gzweigle/DIY-Grand-Digital-Piano/(threads)

Thread 3 (2023-11-26):

add hardware project files

gzweigle, 2023-11-26:
Released are gerber only.

gzweigle, 2024-04-07:
Done. Added KiCad project files and the KiCad libraries I created.

Closed 2024-04-07.

Thread 6 (2023-12-10):

HW: USB MIDI?

davidedelvento, 2023-12-10:
Great to see that you included DIN-MIDI. It's not clear if the now-more-popular USB-MIDI is supported already. If not, it should be relatively easy to add, since the Teensy 4.1 can act as a USB Host. I did that with the [pico](https://github.com/davidedelvento/Mybrid/tree/main/RaspberryPiPico) using https://github.com/hathach/tinyusb so it should be similarly easy on the Teensy (if not done already -- if done already, this "bug" is mentioning it on the main README)

gzweigle, 2023-12-10:
I wish Teensy was not host.  But yeah good suggestion for future.

gzweigle, 2024-09-02:
I added to the IPS 2.1 enhancement list.
Closing this issue since it is now a duplicate

Closed 2024-09-02.

Thread 7 (2023-12-10):

FW: Pedal options?

davidedelvento, 2023-12-10:
The README mentions the option to use external pedals with 1/4" connections, which is great.

Some people (like me :wink: ) may would like to use an existing acoustic pedal, with a sensor similar/identical to the ones for the keys/dampers.

Looking at https://github.com/gzweigle/DIY-Grand-Digital-Piano/tree/main/packages/StemPianoG#pedal-connections it may seem that this is already possible, if my understanding is correct. If so, update the main README accordingly, specifying this option, otherwise let's discuss here what it would take to make it possible

gzweigle, 2023-12-10:
StemPianoG code does not support (yet) but hardware does support. So, I will leave here as an enhancement idea, then update documentation if code is modified in future.

gzweigle, 2024-09-02:
code supports, if needs modification for a specific pedal model will open a new issue for that case.

Closed 2024-09-02.

Thread 8 (2023-12-10):

Number of SCA cards

davidedelvento, 2023-12-10:
If my understanding is correct, one needs 16 SCA cards for the hammers and 16 for the dampers. Is that correct?
If so, write it in the paragraph https://github.com/gzweigle/DIY-Grand-Digital-Piano/tree/main/packages/StemPianoG#six-channel-analog-pcb-link

gzweigle, 2023-12-10:
Just one is needed. I clarified in documentation per suggestion. Thanks!

Closed 2023-12-10.

Thread 9 (2023-12-10):

FW, ME: Selecting hammers/dampers in the IPS boards

davidedelvento, 2023-12-10:
Let's assume that one wants to have both hammers and dampers sensors. If my understanding is correct, current firmware require wiring *all* hammers (via SCA boards) to one IPS board and *all* dampers (again via SCA boards) to *the other* IPS board.

I think it would make it much easier wiring (shorter wires and less crossing cables) and much more efficient use of resources if each board could be configured (in firmware) to act as a hybrid hammers/dampers IPS for half the keyboard. The wiring is clear: you will be wiring only half the keyboard to one board, and the other half to the other board, halving the total length of the cables (potentially reducing noise when doing so, but I am not sure).

For the "more efficient use of resources" consider this scenario to begin: nothing is playing on the piano, both boards (and their ADCs in the SCA boards) are "frantically" sampling all sensors waiting for something to happen. Well, sampling the dampers is unnecessary, so that's the first waste, but that's not my main concern. The main concern is that sampling must be fast to make sure the latency between "key is played" and "MIDI signal is sent" is the lowest possible. Since the ADCs are multiplexed, we are not as fast as possible with the hardware we have. If a single board could be used to sample *both* hammers and dampers, the ADCs can be multiplexed at twice the frequency (because there is no need to check the damper until the note has been played), effectively having the ADC latency with no change in hw. Similarly, the software could probably be prevented from spending cycles checking the dampers until the note is played.

Of course this optimization cannot be used when a note is being held, because in such scenario it could be either re-played or it could be released and to detect what happens we must sample both the hammer and the damper sensor. But only about 10 notes can be held at a same time (given the players typically have 10 fingers), so *still* the optimization will work with 78/88 ~ 88% efficiency! It would be particularly useful if the dampers for one note will be assigned to a SCA board *different* from the corresponding hammer. Why? Because as described above when a note is held one has to monitor both hammer and damper and that would decrease the sampling rate when one needs it most, i.e. when the likelihood of repetitions and nearby note playing is highest.

Would this be extremely complicated with current firmware (which I have not studied yet) or is it doable? I'm willing to contribute to software and wiring scheme design if you deem it worthwhile.

gzweigle, 2023-12-10:
The present released code scans all 96 inputs every 400 microseconds (adc_sample_period_microseconds in hammer_settings.cpp).
My plan to go faster was more ADC on SCA, running in parallel (up to 6x fast is possible).
But agree, another approach is as described above.  No board spins needed.

gzweigle, 2024-06-10:
An advantage of present approach is single MIDI output.
Also, I have optimized the firmware to get the sample period down to 300 microseconds.

I've been playing the piano regularly for over half a year and the piano plays very well at this sample rate. Especially after fixing many sources of error (per YouTube video I recently posted).

My roadmap for faster sample rate remains the ADC parallelization on SCA, which requires only changes to the small, removable, SCA card.

The proposed architecture is very interesting but I in the interest of keeping the backlog small, I am considering to close this issue. Comments?

davidedelvento, 2024-06-10:
Yes, single MIDI out is highly desirable, but I don't see how it's relevant here? Probably just my ignorance here, this is what I am thinking: if you have separate hammer and damper boards each with 88 (or 96) channels, vs having two boards each one using half the keys but both hammers and dampers? If you need single MIDI out, in both cases the two boards need to communicate with each other and consolidate the output. If that consolidation code does not exist yet and it's not a priority to write it yet, in one case you have note-on from one board and note-off from another (which can be problematic for digital instruments), whereas in the other you have note-on and note-off from the same board (just for different note-number) which should be easier on the receiving size.

Moreover, IMHO, one big advantage of this approach is also the wiring: each board can be located closer to the relevant keys, simplifying wiring a lot.

Regarding your actual question about the ADC thing, I have no strong opinion, and the only opinion I have is not backed by data, since I have not been using a complete instrument as you have. I would just note that this aspect may be related to #55 but on that topic too you know that part better than I can comment.

So in conclusion, my opinion is that this is still a desirable feature to implement (leave the issue open), even though it may not be as important for some of the goals I originally mentioned, such as increase ADC rate (deprioritize).

gzweigle, 2024-06-10:
I am happy to leave open. I agree on the wire length benefit.

With present architecture, dampers are optional.  Just add a damper board (identical to hammer board). Nothing else changes.

With respect to MIDI - it is output from the hammer board only.  Damper measurements are sent over CAN bus from damper board to hammer board. Hammer board consolidates to a single MIDI output.  The dampers, as you correctly noted, require less resolution and so I was able to fit all damper data over the relatively slow CAN bus.

gzweigle, 2024-06-10:
Here is the damper board to hammer board code:

https://github.com/gzweigle/DIY-Grand-Digital-Piano/blob/main/firmware/releases/StemPianoIPS2/src/board2board.cpp

gzweigle, 2025-04-26:
Its been a while. All info remains in the issue history and can find with * search.

Closed 2025-04-26.

Thread 12 (2024-01-01):

Vref and sensor resistor

gzweigle, 2024-01-01:
I can get better accuracy by changing the SCA voltage reference part and the HPS load resistor value.

gzweigle, 2024-01-04:
bill of materials have been modified to change load resistor and reference.
Need to test with hardware before closing the issue.

Closed 2024-01-15.

Thread 13 (2024-01-13):

FW: repetition false strike

gzweigle, 2024-01-13:
repro:
Press piano key quickly.
Slowly release key until jack moves beneath knuckle.
Hammer moves up.
On an acoustic piano, hammer does not hit string.
With stem piano sometimes get a false strike.

soln:
Probably can fix with firmware and might also need more consistent sensor placement.

davidedelvento, 2024-01-14:
> With stem piano sometimes get a false strike.

I haven't looked at your code, but with other codes I've played with (mine and Jay's), this is the first basic calibration that one needs to do! That's the advantage to have a mostly software (unlike Cybrid which is mostly hardware) design.

You have to play slowly (actually could even just raise the hammer manually rather than with the key) without hitting the string/sensor. That needs to be calibrated as "let off" position. Then you have to have the hammer hitting the string/sensor and calibrate that as "play" or something. You need to do that for each and every key because both the sensors and their placement will be different from one key to another. On Cybrid, you do that with the potentiometers (huge pain), with Mybrid and Jay's piano-conversion (and I assume you can do that with yours) you write a routine in which you ask the player to play each and every key first silently then not-silently and use those 88+88 values from the ADCs as calibration values. A fancy calibration GUI/script may allow to recalibrate only some notes rather than everything or globally shift everything up or down etc.

davidedelvento, 2024-01-14:
See also: https://github.com/jkominek/piano-conversion/wiki/Calibration-Procedure

gzweigle, 2024-04-20:
this seems to have been fixed by other changes. will close for now and reopen if happens again.

Closed 2024-04-20.

Thread 14 (2024-01-13):

ME: note consistency

gzweigle, 2024-01-13:
repro:
Play multiple notes with same velocity. For example, using a ruler.
MIDI value is not exactly same for all notes.

soln:
Probably sensor consistency.
ADC - differential?

davidedelvento, 2024-01-14:
Again, https://github.com/jkominek/piano-conversion/wiki/Calibration-Procedure has some ideas on this. One could make the calibration procedure I described in #13 also ask for a fff strike and use that to calibrate the slope of the velocity computation. That is a bit tricky because while it's easy to raise the hammer to let-off without it going much higher, and it's also easy to have the hammer strike the sensor/string with "whatever" velocity, it's much harder to make it strike it with consistent velocity. I speculate (and my preliminary tests I described in the Mybrid repo confirm) that this calibration is not necessary once one has calibrated the let-off and the strike point and hence measured velocity only between these two values. But then I only had a handful of notes working, never a full set as you do, so I might be missing something, either on the user "feeling" side or on the sensor variability side. Also, my sensors different than yours and are probably mounted with a bit tighter tolerances, as you have probably already seen at https://pianoclack.com/forum/d/542-update-on-piano-conversion/

gzweigle, 2024-01-15:
I'm in the process of checking in details of a system I built to accurately measure sensor response.

gzweigle, 2024-04-20:
improved by a combination of rebuild/regulate action, redrill sensor bar with more accuracy, and real-time algorithm in firmware (code is in repo now)

Closed 2024-04-20.

Thread 15 (2024-01-13):

power supply noise

gzweigle, 2024-01-13:
repro:
Detailed measurements show quite a bit of 120 Hz noise.

soln:
Better +5V power supply.
Look at grounding.
Differential ADC.
Filters.

davidedelvento, 2024-01-14:
One of the most notably effect of power supply noise is on the intensity of the LED light, which in turns would cause a change of measured distance (unless it's very carefully calibrated, which IMHO is a big pain) with that frequency. That could turn out as a subtle modulation of the velocity at that frequency, since when we are in a peak intensity the hammers would appear to be closer (and hence hit the string/sensors earlier, and hence have a higher velocity/loudness) and the reverse when we are in a trough with hammers appearing more distance and etc-etc lower velocity/loudness.

See https://github.com/jkominek/piano-conversion/wiki/LED-Power-Board for a solution to this problem, which also has the added benefit to removing the needs of all those current-limiting resistors which are needless power sink. Not much each, but even a fraction of a watt when multiplied by 176 becomes non-negligible (that explain the lack of such resistors in my sensorboards as we were discussing elsewhere)

gzweigle, 2024-01-21:
Turns out this was due to ambient room lighting shining on the sensors.
With sensors shielded, the 120 Hz noise goes away.

Closed 2024-01-21.

Thread 16 (2024-01-13):

FW: CNY70 accuracy

gzweigle, 2024-01-13:
Working on calibration for nonlinearity and sensor-to-sensor variations.
Need to improve sensor placement variation.

gzweigle, 2024-04-20:
combination of rebuild/regulate action, redrill sensor bar with more accuracy, and real-time algorithm in firmware (code is in repo now)

Closed 2024-04-20.

Thread 17 (2024-01-13):

ME: wiring

gzweigle, 2024-01-13:
Working on cleaner wiring of boards and sensors.

davidedelvento, 2024-01-14:
You have seen this https://pianoclack.com/forum/d/637-build-your-own-hybrid-piano-step-four-the-cables haven't you?

gzweigle, 2024-08-10:
Will do someday but since not documented in GitHub, no need for an open issue.

Closed 2024-08-10.

Thread 18 (2024-01-13):

normalization and gain control

gzweigle, 2024-01-13:
This code is presently a work-around.
gain_control.cpp
vscale in src_hammer.cpp
Needs rethinking.
For example, eliminate velocity normalization with the switches.  Make it auto.

gzweigle, 2024-03-31:
I removed most of this code.

Closed 2024-03-31.

Thread 19 (2024-01-21):

FW: wrong hammer distance

gzweigle, 2024-01-21:
In hammer settings, this distance is measured at the CNY70 sensor location (.3125 inches).  It should be the distance at the hammer (closer to about 2 inches).
hammer_travel_meters = .0254 * 0.3125;

gzweigle, 2024-04-20:
subset of issue #28

Closed 2024-04-20.

Thread 20 (2024-01-23):

the video "Step 4 - Piano Action Frame" is private. Could you give a new link?

BetsyTsng, 2024-01-23:
the video "Step 4 - Piano Action Frame" is private. Could you give a new link?

BetsyTsng, 2024-01-24:
i really need this video to learn how to make frame of the action.

davidedelvento, 2024-01-27:
https://pianoclack.com/forum/d/170-build-your-own-hybrid-piano-step-two-the-cabinet/7

BetsyTsng, 2024-01-28:
sorry, i read carefully this repo, and found that this video just not be done.

gzweigle, 2024-01-29:
Thanks, yes it is not done.

gzweigle, 2024-03-17:
I changed the video to public and also made a video documenting issues with it.

Closed 2024-01-29.

Thread 21 (2024-02-20):

Video for "Piano Action Frame" is set to private

WebSnke, 2024-02-20:
Hi, I am a huge fan of this project and would love to build my own. However, the video for building the piano action frame is set to private.
Is this intentional or just a mistake?

davidedelvento, 2024-02-20:
Duplicate of #20

gzweigle, 2024-02-22:
https://github.com/gzweigle/DIY-Grand-Digital-Piano/discussions/22

WebSnke, 2024-02-23:
> Duplicate of #20

Yeah, noticed that too...
Btw, has anyone managed to put this into an upgright piano action?

davidedelvento, 2024-02-24:
> has anyone managed to put this into an upgright piano action?

That would be better for another issue or a discussion item e.g. on https://pianoclack.com/forum/

Hope Greg don't mind too much for me answering here instead. I don't think anybody has done that. In a nutshell, upright pianos have the following limitations:

* the action is harder to remove (not extremely hard, but harder than grand) and when removed, unless you have specialized equipment, you are guaranteed to break it because it you cannot lay it in any position without having the whole weight pushing on a brittle part, unlike in a grand where you can just pull it out and place it on any table
* the keyboard is part of the cabinet and cannot be removed, if not one key at the time (and then you need to rebuild a keyframe), unlike in a grand where the keyboard is attached to the action
* if you want to reuse the upright cabinet you may want to remove the harp to make it lighter. This is close to impossible (unlike in a grand, where it is easy if you have a hoist, and demanding but not too hard if you work with *several* people in the operation)
* if you don't remove the harp, you have to remove all the strings, which is a very long, tedious and dangerous job -- at that point you have very limited working space for the sensors. Again, not impossible, but much harder than a grand
* assuming that you succeed in all of the above, you end up with an arguably inferior action than a grand, after having done much more work -- hence I don't see why one would embark in such an endeavor.
* anticipating an answer of "but I don't have room for a grand in my house", my comment is "me neither" and in fact I made an "upright" (actually a spinet) out of a grand action. That was EASY. See https://pianoclack.com/forum/d/170-build-your-own-hybrid-piano-step-two-the-cabinet for details.

WebSnke, 2024-02-24:
Thanks for your response. Let's continue this on the forum.

Closed 2024-02-20.

Thread 23 (2024-03-31):

TFT doesn't clear

gzweigle, 2024-03-31:
When switch to display mode, it doesn't clear properly.

gzweigle, 2024-04-13:
fixed

Closed 2024-04-13.

Thread 25 (2024-04-07):

HW: surface mount HPS without trimmer

gzweigle, 2024-04-07:
The surface mount HPS (v6 and v7) also include the trimming resistor.
The trimming resistor is expensive.
Need a surface mount version of HPS without the trimming resistor.
So, same as v4 but surface mount.

gzweigle, 2024-04-20:
HPS 0.8 is in testing.

gzweigle, 2024-05-05:
Added - https://github.com/gzweigle/DIY-Grand-Digital-Piano/tree/main/hardware/releases/hps08/hps08_gerber
Until fully tested, leaving issue open

gzweigle, 2024-06-09:
it works

Closed 2024-06-09.

Thread 26 (2024-04-14):

HW: pedal voltage exceeds Vref

gzweigle, 2024-04-14:
The pedal inputs have pullups to VDD.
Two problems:
1. clipping at ADC.
2. The ADC max input is Vref + 0.3V.

The firmware handles this ok. Its been working for months.

However, should add a resistor to IPS 2.0 PCB to keep voltage in range 0 to Vref.
Use design from first architecture:
https://youtu.be/9sqkgVXceJU?t=63

gzweigle, 2024-04-16:
Looks like I can fix this, without changing any existing PCB, by making a tiny removable resistor divider board that snaps on IPS.
Because fortunately I connected the pedals through a header.
In hindsight, this is the preferred approach anyway because VREF is configurable.
Missing the impact of configurable VREF on pedals is what caused the "hardware bug".
So, need a configurable pedal output voltage. Hence the new board.
In process of building and testing the idea.

gzweigle, 2024-06-09:
Added the hardware files and updated the documentation.

Closed 2024-06-09.

Thread 27 (2024-04-14):

HW: crosstalk

gzweigle, 2024-04-14:
In working on note-to-note consistency, I notice a slight cross-talk between channels (notes).
Need to track this down.

davidedelvento, 2024-04-14:
I suspect optical crosstalk from the sensors themselves. I noticed this in my preliminary testing and it is one of the reasons I settled on the QRE1113 rather than the CNY70

gzweigle, 2024-04-14:
Interesting.  I will investigate. Am thinking (hoping) that it is an issue with my test setup, not the circuits.

I am taking very precise test position measurements so seeing interesting phenomena. For example, measurements influenced by leaning against piano slightly during test!

gzweigle, 2024-04-14:
test setup

Closed 2024-04-14.

Thread 28 (2024-04-15):

FW: velocity to midi

gzweigle, 2024-04-15:
Algorithm is a proportional mapping.
Adjustments have been with external MIDI software velocity curve.
Needs:
1. Rigorous derivation of correct relationship.
2. Documentation.

gzweigle, 2024-05-04:
Keep proportional.
Add calibration option.

Closed 2024-05-04.

Thread 31 (2024-04-21):

FW: damper code out of date

gzweigle, 2024-04-21:
Been testing and editing firmware with hammers to estimate dampers.
Need to bring code for separate damper board up to date.

gzweigle, 2024-07-21:
fixed

Closed 2024-07-21.

Thread 33 (2024-04-27):

HW: higher current LDO

gzweigle, 2024-04-27:
1.75A / 6 = 291mA which is too close to the 300mA in parts list.

gzweigle, 2024-04-27:
Consider TLV755P (500mA) in place of existing TLV733P (300mA).  Also increase input / output capacitance.

The stem piano documentation says 1.75A. The test results were 1.5A.

1.5A / 6 = 250mA < 300mA LDO.

However, one of the LDO is also powering the SCA.

gzweigle, 2024-04-28:
More clearly explain HPS current constraints:
https://github.com/stem-piano/stem-piano-g-main/blob/main/documentation/component_manual.md

Add HPS current measurement table:
https://github.com/gzweigle/DIY-Grand-Digital-Piano/tree/main/hardware/releases/hps07

Closed 2024-04-28.

Thread 38 (2024-04-27):

DOC: min HPS output voltage

gzweigle, 2024-04-27:
I put 2.25V in the documentation. Lower should be possible.

https://github.com/stem-piano/stem-piano-g-main/blob/main/documentation/hps_testing.md

gzweigle, 2024-04-28:
Verify that lower works and adjusted the documentation.

Closed 2024-04-28.

Thread 40 (2024-04-28):

FW: small voltage calibration

gzweigle, 2024-04-28:
For HPS-70 that are far from nominal, may need a two-step calibration.
First a gain, then the curve adjust.

gzweigle, 2024-06-10:
Analysis and testing shows the existing automatic calibration algorithm works well even for outliers.
Therefore, not going to work on a two-step calibration algorithm.

Closed 2024-06-10.

Thread 41 (2024-05-04):

HW: no sca connector labels on ips

gzweigle, 2024-05-04:
The ips parts list does not include the four sca socket connectors.
Missed it because used a custom symbol in schematic, resulting in no connector labels on ips board.

gzweigle, 2024-06-15:
added to bill of materials for ips20

Closed 2024-06-15.

Thread 43 (2024-05-05):

HW: location of sensor resistor

davidedelvento, 2024-05-05:
I am wondering if you have considered putting the sensor resistor after the multiplexers, so you would not need to have (solder) 88 of them.
In my case that's obviously because I don't want to modify my sensorboards which have been already fabricated without, and I don't want to massively change your main board either with 88 resistors. Obviously I could have them in the cables and that might be my chosen route, but putting them after the multiplexer seems also doable, so asking if you considered that (and perhaps discarded it for some reasons).

gzweigle, 2024-05-05:
I ran SPICE simulations of various options last year.
Settling time (to ADC resolution) limits the sample rate of every option.
So I need the circuit to settle as quickly as possible.
CNY70 trying to drive through multiplexers slowed things down too much.
An amp (ie TIA) improves the no-resistor settling time problem but only if before the multiplexers, then need 88 amplifiers.
Key goal of stem piano G is lowest possible cost.

However, stem piano G is pretty much done. Maybe next piano should be with amps vs. R.

For reference, these diagrams show the ADC timings, although not the settling time simulations:
https://github.com/gzweigle/DIY-Grand-Digital-Piano/blob/main/design/data_acquisition/eca0X_ips2X/eca0X_ips2X_timing_design.md

davidedelvento, 2024-05-05:
Yes, that's exactly what I had in mind, but just as "gut feeling". So with current design it is better to put the resistors in between the multiplexers and the sensors.

> An amp (ie TIA) improves the no-resistor settling time problem but only if before
> the multiplexers, then need 88 amplifiers. Key goal of stem piano G is lowest possible cost.

Well, using TIA is not too bad, many IC have several op amps in the same package and cost only pennies. FWIW, that's what https://github.com/jkominek/piano-conversion/ intend(ed?) to use see https://github.com/jkominek/piano-conversion/wiki/Analog-Stage-Theory-of-Operation#transimpedance-amplifier
In fact I might for intermediate board(s) on which I will mount resistors for now and which I will replace with a TIA later.

Maybe for the next version of the sensorboards you may do the same so you will increase flexibility (i.e. not require replacing 88 expensive sensorboards) if one decides to switch between options.

Thanks for the discussion!

gzweigle, 2024-05-05:
Thanks. Agree.

Closed 2024-05-05.

Thread 44 (2024-05-05):

FW: option to use optical sensors for pedals

davidedelvento, 2024-05-05:
In your design you have 3 jacks for external pedals. In a full DIY grand (such as the one I have built), one may want to use the original pedals and use the same optical sensors (properly mechanically adjusted for the pedal travels) instead. Since the design already has 96 channels and most pianos have 88 keys, it should be easy to allocate 1, 2 or 3 channels to the pedals.

gzweigle, 2024-05-05:
Yes that will work.
Cases like that are exactly why I put header J46. Can bypass the jacks for up to 8 pedals.
See pedal section of:
https://github.com/stem-piano/stem-piano-g-main/blob/main/documentation/assembly_manual.md
Skip the wires, connect direct to J41, 43, 45.

davidedelvento, 2024-05-05:
Oh, I missed that, it's great!
So it's already supported in firmware?

gzweigle, 2024-05-05:
Just minor firmware changes.

davidedelvento, 2024-12-15:
I attempted to get this to work in the most naive way, and I went nowhere. Before I spend too much time going in the wrong direction, and reverse engineering what you have done, can you please nudge me towards what you had in mind here?

My pedal sensors are identical to your key sensors, so I need the three-way connector (I see that in the wiring diagram you connect only two). Also, it (wrongly?) appears to me that you wire two ADC channel per pedal, but one of such channel is just a "flag" and currently not in use. Is that right?

TIA!

gzweigle, 2024-12-15:
Yes the pedal jacks have two outputs.
One output is the pedal analog signal.
The other output is an optional indicator "flag" that the pedal is connected.

On the IPS 2.0 circuit board, each output goes to a separate ADC channel.
And, yes, correct, the pedal connection indicator "flag" is not used by the firmware.

Connecting a pedal directly to the header at the back of the IPS 2.0 circuit board should work.  Since all the pedal jack is doing is writing to one of the ADC channels.

davidedelvento, 2024-12-16:
Thanks, so to confirm:

1. I don't have to change anything in the multiplexer code, that channel is already read by the default multiplexing settings of the firmware
2. The power is also properly connected so if I attach a key sensor (equivalent to your HSB, not mine which has external power) to the pedal channel, that key should act as a pedal -- and if I don't see any MIDI pedal message that's a problem with either wiring or sensor (not firmware)

Correct?

gzweigle, 2024-12-16:
(1) - There is a setting for which ADC channel routes to the pedal algorithm in the firmware.  The setting allows any of the 96 inputs to be used for pedal(s).
https://github.com/gzweigle/open-hybrid-piano/blob/main/firmware/releases/ips2_hammer/hammer_settings.cpp

(2) - The HPS sensors require 3.3V and ground connections so those two of the three IPS/HPS pins are "outputs" to the HPS. If your pedal gets power by another means, then only one connection is required from the pedal to the IPS board.

Note that pedals with a passive variable resistor will need some way to bias and set the proper output voltage to the ADC.   This is the purpose of the pedal level shift (PLS) card.
https://github.com/gzweigle/open-hybrid-piano/tree/main/hardware/releases/pls00

davidedelvento, 2024-12-16:
(1) perfect thanks

(2) I must not have explained myself -- My pedal is not a digital piano pedal (neither active nor passive). My pedal is the original pedal from the acoustic piano I took the action from! I have installed an HPS into it. As such it does need power and ground.

Given what you wrote in (1) I assume that from the hardware perspective those additional pins are correctly wired to power and ground and if my pedal is not working (which is the case) something else in the wiring or in the sensor must be wrong. Next weekend I will start debugging from there

Thanks!

davidedelvento, 2025-01-04:
Is it supposed to output continuous values? Looking at the code I'd say yes, but....

I managed to get it to work, but it outputs only 0 or 127 on CC64 (sustain). Have you tried hooking one of the optical sensors and verified it gives intermediate values too?

Closed 2024-05-05.

Thread 45 (2024-05-05):

HW: LDO current

gzweigle, 2024-05-05:
LDO in parts list is ok but realized that if want an expanded SCA in future, it could require more current.
Better to find a larger part, test it, then put in parts list.

gzweigle, 2024-06-15:
In the ips20 bill of materials:
(1) replace the 300mA TLV73333PQDBV with 500mA TLV75533PDBVR.
(2) replace the 1uF LDO capacitors with 10uF. Input and output.

Solder a replacement of one new LDO on IPS 2.0 (U11).  Test.
The max current increases and also tests show get slightly better noise performance.

Link:
https://github.com/gzweigle/DIY-Grand-Digital-Piano/blob/main/hardware/releases/ips20/ips20_bill_of_materials.txt

Closed 2024-06-15.

Thread 46 (2024-05-11):

FW: add dynamic range to eeprom

gzweigle, 2024-05-11:

gzweigle, 2024-06-30:
Adding the dynamic velocity scaling value to EEPROM seemed simple on the surface but I wound up refactoring the entire velocity scaling code and this also impacted the position calibration code. So, addressing this issue became a fairly significant code change. It is done and tested now.

Closed 2024-06-30.

Thread 47 (2024-05-11):

FW: cal rare outlier

gzweigle, 2024-05-11:
Get an outlier that breaks calibration for a single note.
Happens very rarely.

davidedelvento, 2024-05-11:
What do you mean by "breaks calibration"?

gzweigle, 2024-05-11:
The firmware is now automatically compensating for sensor nonlinearity.

Its a huge improvement over the problems I described in my last YouTube video.

(for my skill level) the piano "regulation" is now very good.  And, I have ideas to make even better too.

However, on rare occasions a note will go out of calibration. Then that note sounds slightly louder or quieter than others. My guess is: either a firmware bug or unexpected/unknown noise.

Code link:
https://github.com/gzweigle/DIY-Grand-Digital-Piano/blob/main/firmware/releases/StemPianoIPS2/src/calibration_sensor.cpp

davidedelvento, 2024-05-11:
Ah, very nice! I am preparing/purchasing what I need to finally solder/assemble one (still need to figure out the PCB order), and I hope that by the end of June I will be able to contribute something more specific to (minor) issues like this!!

gzweigle, 2024-05-11:
cool.
I need to get a few very minor HW changes in.

Also, slowly migrating to a GitHub organization https://github.com/stem-piano/

Going slow because of all the links to original.

gzweigle, 2024-08-10:
Can't repro

Closed 2024-08-10.

Thread 48 (2024-05-11):

FW: flash LED on eeprom write

gzweigle, 2024-05-11:
Give user an indication EEPROM is being written.

gzweigle, 2024-06-10:
calibration LED stops flashing momentarily during EEPROM writes.

Closed 2024-06-10.

Thread 49 (2024-05-11):

FW: swap calibration switches

gzweigle, 2024-05-11:
Notice using piano that its easier to use if they are swapped

gzweigle, 2024-06-09:
Changed my mind. Leave as-is.

Closed 2024-06-09.

Thread 50 (2024-05-11):

HW: add ground pin to J46

gzweigle, 2024-05-11:
In support of https://github.com/gzweigle/DIY-Grand-Digital-Piano/issues/26, adding a ground pin to J46 cleans things up.
Board will work without this.

gzweigle, 2024-06-15:
Merge to https://github.com/gzweigle/DIY-Grand-Digital-Piano/issues/52

Closed 2024-06-15.

Thread 51 (2024-05-12):

FW: setup network during runtime

gzweigle, 2024-05-12:
line 181 of https://github.com/gzweigle/DIY-Grand-Digital-Piano/blob/main/firmware/releases/StemPianoIPS2/src/network.cpp pauses runtime for a few seconds shortly after reboot.
This code was recently added to make Ethernet optional with a config switch.
Maybe it doesn't matter? Either move to startup() or verify ok.

gzweigle, 2024-06-09:
fixing this bug also simplified the code.

Closed 2024-06-09.

Thread 52 (2024-05-13):

HW: new IPS 2.1

gzweigle, 2024-05-13:
Presently working on a new iteration of the IPS mainboard.
Goal: all changes compatible with existing IPS 2.0 firmware.

Moving CAN connector to rear of board.
Adding another LED/testpoint to front by Teensy (making TFT IRQ optional with a jumper resistor).
Putting extension SCA power on main 3.3V instead of an LDO 3.3V.
Move J46 to right.

Investigating adding 96 optional 805 surface mount resistors to bottom side of board in support of another sensor approach:
https://github.com/stem-piano/sensor-systems/tree/main/qps

Addressing these existing issues:
(1) Adding ground pin to J46
https://github.com/gzweigle/DIY-Grand-Digital-Piano/issues/50
As optional gnd connect point for new PLS board: https://github.com/gzweigle/DIY-Grand-Digital-Piano/issues/26
(2) Adding SCA connector labels
https://github.com/gzweigle/DIY-Grand-Digital-Piano/issues/41
(3) BOM - changing LDO part
https://github.com/gzweigle/DIY-Grand-Digital-Piano/issues/45

davidedelvento, 2024-05-13:
Awesome!!
If it's not too many irons in the fire, maybe investigate adding some TIAs. If they need to be before the mux (and hence be 96 of them) perhaps it's better to make an interposer board. If they can be after the mux (and hence just a hanful) putting them on the IPS makes more sense. We'd need to run some simulation (if you haven't already)

gzweigle, 2024-06-08:
> perhaps it's better to make an interposer board

Good point.  Will use the 96 sensor headers.  Created issue: https://github.com/gzweigle/DIY-Grand-Digital-Piano/issues/53

Therefore:
- Removing the 96 805 surface mount resistors from scope of IPS 2.1.
- These (and optional TIA) will be on the new removable sensor interface boards.

This means that, while IPS 2.1 has some nice improvements, its not necessary.  The existing IPS 2.0 is ok.  So, likely I will lower the priority of creating IPS 2.1.

gzweigle, 2024-06-15:
Updated list of changes from IPS 2.0 to IPS 2.1:
(1) Move CAN connector next to quarter inch jacks.
(2) Add another LED/testpoint to front by Teensy (making TFT IRQ optional with a jumper resistor).
(3) Put extension SCA power on main 3.3V instead of an LDO 3.3V.
(4) Move J46 to right to make room for CAN.

(5) Add ground pin to J46: https://github.com/gzweigle/DIY-Grand-Digital-Piano/issues/50
(6) Adding SCA connector labels: https://github.com/gzweigle/DIY-Grand-Digital-Piano/issues/41

IPS 2.1 is on hold because these improvements are minor.

gzweigle, 2024-06-23:
Another addition for IPS 2.1. Jumper on R23, R25, and R28 so can use active or passive pedals without having to change whether resistors are soldered onto the board.

gzweigle, 2024-07-01:
Another one - for both Teensy and SCA, include the headers in the schematic.

gzweigle, 2024-07-12:
Another one - external connection for a USB MIDI port in addition to the serial MIDI port.

gzweigle, 2024-07-12:
More improvements for IPS 2.1:
The +5V - USB power info printed on the circuit board are overly restrictive.
Could also add information like this on back of board?

davidedelvento, 2024-07-13:
Since you are planning to redo this, in my opinion is better to do as vagfilm mentioned: replace all of these with just headers and let all the jacks to be "floating". This will greatly simplify assembly, allow more flexibility, and provide the option to build a nice enclosure where the jacks can be safely attached without risk of stressing/ruining the PCB by continued use.

gzweigle, 2024-07-13:
Its a good idea to make a version with a smaller PCB, no TFT or quarter inch inputs.

Note that presently all 96 inputs are independently available along the back of the PCB. The quarter inch jacks connect only to header J46 and nothing else. Does that answer the first question?

davidedelvento, 2024-07-13:
> Its a good idea to make a version with a smaller PCB, no TFT or quarter inch inputs.

Agreed. I would go as much as to not have Ethernet, MIDI, power supply jack or anything. But I don't mean that these are not possible, just that they are not directly attached to the board. In fact, I think all of them (including the TFT) would be at least "nice to have" if not "absolutely needed" but the design could be better served if all of them are attached to the board via a ribbon cable and then mechanically held somewhere else (e.g. in the enclosure).

> Note that presently all 96 inputs are independently available along the back of the PCB.
> The quarter inch jacks connect only to header J46 and nothing else.
> Does that answer the first question?

I guess you mean the other ticket? If so, yes. In this issue report I didn't have any question in my ticket only a suggestion (which you are free to consider or reject as you see fit, obviously).

gzweigle, 2024-07-14:
Interesting idea... I could put everything optional, or that could have variants, with cable connectors.

gzweigle, 2024-07-26:
Info on circuit board include to cut 5V pad

gzweigle, 2024-09-02:
Add USB host connection

gzweigle, 2024-09-02:
For USB host - see this discussion: https://github.com/gzweigle/DIY-Grand-Digital-Piano/issues/6

technolhodgy, 2024-09-02:
I have been keeping up with you Youtube Video's
This is a great project, and I look forward to seeing it progress.

I picked up a Grand Action last year that was going to be broken down.
I have just about had an octave working on a Pi Pico, and plan to scale it up to 88 notes soon.

gzweigle, 2024-09-07:
Consolidated change list (so far!) to consider for a future IPS 2.1 board spin, along with a few additional items:

Features:
USB MIDI (I think it has to be host?) connection.
Quarter inch jack interposer board instead of presently forcing specific quarter inch jack types.
Push button in addition to switches.
Dedicated TFT processor with fast command-based processor2processor interface.

Improvements:
Move CAN connector to back of board.
J46 – move to make room for CAN.
Add another LED/testpoint to front by Teensy (making TFT IRQ optional with a jumper resistor).
Put extension SCA power on main 3.3V instead of an LDO 3.3V.
J46 – add ground pin.
Jumper on R23, R25, and R28 so can use active or passive pedals through the quarter inch jacks without solder change.
Socket the fuse.
TFT LDO.
Move Teensy forward

Labels:
SCA connector labels.
For both Teensy and SCA, include the headers in the schematic.
New +5V - USB power info on circuit board.
Put additional instructions on back silkscreen.

Fixes:
Add external pullups to switches (addressing a Teensy problem).

General:
Could I keep it "99%" compatible with IPS 2.0 codebase?

davidedelvento, 2024-09-08:
> USB MIDI (I think it has to be host?) connection.

- [ ] No why do you want to make host? A keyboard is a device and so this should be.
- [ ] I have other things to discuss but let me open a separate issue for them, not to pollute this one with discussion but leaving it just as a list of things which you will have concluded are worth implementing -- in fact I will delete this comment if you ask me to, so we keep this issue clean
- [ ] speaking of lists, see how you can make it very nicely? Click on the "checklist" icon to the left of the paperclip (you should be able to edit your earlier message)

gzweigle, 2024-09-21:
See if can make space for stickers next to LED.  Then, a user can make it easy to identify the LED function based on the firmware.

gzweigle, 2024-09-28:
Moving the comment from issue https://github.com/gzweigle/DIY-Grand-Digital-Piano/issues/94 to this consolidated ips 2.1 changes issue.

"The silkscreen for the IPS should include a text saying if the + is inside or outside"

gzweigle, 2025-05-04:
Consider swapping 3.3v and gnd rows at sensor header to simplify wiring in some cases.
See: https://github.com/gzweigle/open-hybrid-piano/issues/96

Thread 53 (2024-06-08):

HW: sensor interface boards

gzweigle, 2024-06-08:
Realized that I can use the 6 header sets on back of IPS mainboard:
(1) J4-J9
(2) J16-J21
(3) J22-J27
(4) J28-J33
(5) J34-J39
(6) J40-J45

To socket 6 small, identical sensor interface printed circuit boards.

Removable.

These can translate any sensor front end interface. Without changes to the IPS mainboard. This makes the system very flexible for any sensor front end or processing in front of the ADC.

For example, put burden resistors or TIAs on the new sensor interface boards.

In process of creating PCB for a few interface options.

gzweigle, 2024-06-20:
The interposer board with resistors is done and tested.
Hardware location:
https://github.com/gzweigle/DIY-Grand-Digital-Piano/tree/main/hardware/releases/aceA00
Instructions:
https://github.com/stem-piano/stem-piano-g-main/blob/main/documentation/assembly_manual.md

Closed 2024-06-20.

Thread 54 (2024-06-08):

HW: change pedal TN pulldown resistor values

gzweigle, 2024-06-08:
The uxcell Audio 6.35mm 1/4 inch pedal connector has two outputs:

T and TN.  Pedal inputs drive the T output.

- T and TN are shorted together when no pedal is connected.  The purpose is that, by grounding TN, it prevents noise on T when a pedal is not connected. This doesn't matter as much to stem piano because T output is processed in firmware. T output does not connect directly to any audio.

- T and TN are open circuited when a pedal is connected.

I put a 100Kohm resistor in the bill of materials for the TN pulldown: R22, R26, R29.

However, that is too much for the SAR ADC. So, TN winds up following T because of the muxing order.

This makes it difficult for the firmware to determine if a pedal is connected.

Its better to connect these TN outputs to ground.  Or, if want a little safety in case of circuit or other error, use a small pulldown resistance for R22, R26, R29.

gzweigle, 2024-06-15:
Test using 10 ohms.
Solder onto an ips20 board and test.
Tests show that the TN stays at ground.

Closed 2024-06-15.

Thread 55 (2024-06-09):

FW: improve the velocity algorithm

gzweigle, 2024-06-09:
During testing and creating most recent video on note-to-note consistency, I notice the reported velocity is less consistent than the hammer position. Probably due to the derivative in algorithm. I have a few ideas to improve and need to get into the code.

davidedelvento, 2024-06-10:
IMHO, the main problem here is how to get a "ground truth" on which to assess the algorithm, and then find the root cause to the inconsistencies. Some questions for you to consider (in addition to what you are already thinking about)
* Is single note velocity always "perfect" for some way of considering perfection? \
* Do you still have the single note action which you could use for testing? Can you install two sensors for that same key and see how they differ from each other, ruling out difference in mechanics/regulation from the noticed difference in measured velocity?

gzweigle, 2024-06-22:
Discoveries/Improvements so far:

(1) For slow strike (quiet note) cannot use the max() algorithm because the hammer travel is under tighter control of pianist than when fast strike (louder note). This could explain why sometimes the piano feels inconsistent when playing ppp. Use a window back from strike point.

(2) Should not use the velocity zero crossing as time of strike because derivative has timing variations susceptible to signal asymmetry. Even though it is linear phase. I have another algorithm.

(3) Tests and data are indicating that the type of foam used for hammer stop may play a bigger role in velocity accuracy than I initially assumed.

None of this in GitHub code yet.

gzweigle, 2024-07-07:
Details of the existing and improved velocity algorithms will be covered in the technical paper:
https://github.com/gzweigle/DIY-Grand-Digital-Piano/issues/73

gzweigle, 2024-08-10:
Added a second algorithm.

Algorithm 0: No thresholds. Less dependent on precise mechanical setup. Longer delay. Less accurate.
Algorithm 1: Uses thresholds. Requires a mechanical setup with tight tolerances. Minimal delay and more accurate.
May add more algorithms in future

Closed 2024-08-10.

Thread 56 (2024-06-10):

On-board ADC usage?

szbergeron, 2024-06-10:
Is there a reason for specificallly using an external ADC for the stem piano, instead of the two on-board ADCs on the teensys?
I've been working on a stem-piano-inspired build with hall effect sensors, and wasn't sure if there's some hidden gotcha I haven't seen. So far, I've been able to push the sample rate high enough that even doing all 88 keys off of one teensy should be fine, but have planned in a leaf/hub architecture anyway just for some extra flexibility

gzweigle, 2024-06-11:
Sounds like a fun and interesting project.

The Teensy ADC is probably ok.

This is because the ADC is likely not the dominant error source. There are many other error sources (I recently listed on the youtube channel).

As for stem piano, it streams all hammer positions over Ethernet. So, I like the 16-bit ADC because with offline processing I can use more sophisticated algorithms to analyze the waveforms.  For what purpose I don’t know yet.

davidedelvento, 2024-06-11:
As Greg said, the internal ADCs are probably okay, but using an external, better ones frees more board resources and eliminate *possible* source of inaccuracies. Whether or not such inaccuracies is debatable and require studying. This is what Jay is doing at https://github.com/jkominek/piano-conversion/discussions/58

So to start your experimenting, you can definitely use the internal ADCs as I have done for example with https://github.com/davidedelvento/Mybrid/tree/main (and Jay has done with the STM32). That may turn out to be "perfect", or "adequate with some limitations" or "not good enough", depending on your goals. In my opinion, the goal of a project like this is to get the very best possible setup (ideally much better than commercial products) with an expense that is relatively inexpensive compared to commercial Hybrid pianos -- hence the use of an external ADC makes sense. If your goal is maximum simplicity or minimal expense, the internal ADC makes more sense. In either case, studying it is very appropriate, so please do share what you find!

szbergeron, 2024-06-14:
Neat, I'm definitely tending toward an "opinionated and functional" thing more than something that gives me all the extra analytics. Using the dual ADCs in parallel I've found gives me about 16 keys (a "batch" to sample) per 40 microseconds or so, and with muxes and key attention I might be able to get this down to just a single teensy, said muxes, some op-amps, and my sensors on a few daisy-chained boards for all 88 keys and assorted controllers.

I'm not really doing this for money-saving, I'm just kind of a dumbass so the less EE work I touch the better. My goal is to do more magic in software to offset for simpler hardware. So far, doing a linear regression of the hammer velocity between let-off and when it "hits the string" with a buffer gap on either end gives me quite stable results, especially with 300+ samples in that distance at what I'd consider "fortissimo" with a single key and attention. I still want to improve SNR a bit so I'm going to try some op-amps to boost the input from the sensors, but that might just be vanity more than anything legitimately necessary

davidedelvento, 2024-06-15:
To avoid reinventing the wheel, consider https://github.com/jkominek/piano-conversion/wiki/Analog-Stage-Theory-of-Operation -- Jay recently also commented that such an configuration is not giving the expected/hoped results, but I can't find that comment now, so you have to dig into the repo looking for his latest verbiage and check exactly what the sentence says, rather than trusting my second-hand report

szbergeron, 2024-06-15:
My read is that the problem is the observed output impedance of the phototransistor in the CNY70? The [1302](https://www.jameco.com/Jameco/Products/ProdDS/2135881.pdf) sensors I'm using only have 5 ohm output impedance at 1ma, and is a powered device with internal amplification already. I'm no EE person, so I'm sorta trying to navigate the runes as I go, but my impression was that stacking op-amps was already relatively common so pairing the internal one with an additional stage should be "fine"? I'm sure I'd run into more issues if I tried to plop an optical sensor in place of hall effect, so my idea of being "sensor agnostic" probably goes out the window. Hall effect seems quite noise free when I use stronger magnets for each key though so fingers crossed I can double down and it turn out ok.

szbergeron, 2024-06-15:
I also realized checking the datasheet for the a1302 again that it really wants a 5v supply, I tried a quick and dirty test and the half-range output at 5v (from 0 measurable field to magnet in contact with sensor) is a much more sensible range so long as I can limit the other side of the range from overvoltage. It does mean 2 power rails, but I can make that happen

Closed 2024-07-21.

Thread 57 (2024-06-16):

HW: resistor type

gzweigle, 2024-06-16:
A few thick film resistors where thin film is better.

hps06_ips2x_bill_of_materials.txt, hps07_ips2x_bill_of_materials.txt:
CRCW080550R0FKTA (50 ohm thick film resistor) replace with ERA-6AED510V (51 ohm thin film resistor).

hps08/hps08_ips2x_bill_of_materials.txt:
Missing the 180 ohm part number. Add: ERA-6AED181V (180 ohm thin resistor).

sca00/sca00_bill_of_materials.txt:
0.2 ohm is thick film, can find alternate?

davidedelvento, 2024-06-16:
https://www.arrow.com/en/products/rl1632r-r200-f/susumu ?
It's only 1% and not better as you might have hoped, but still is thin film and perhaps adequate or at least better than you have already?

gzweigle, 2024-06-16:
Thanks, I will try that resistor.
Closing the issue because checked in parts files with new resistor values and also will test the suggested.

Closed 2024-06-16.

Thread 58 (2024-06-22):

FW: calibration depends on sample rate?

gzweigle, 2024-06-22:
Notice the calibration results changed when changed the sampling rate.
Maybe its ok?
Creating an issue so I don't forget to investigate when have time.

gzweigle, 2024-08-10:
Can't repro

Closed 2024-08-10.

Thread 59 (2024-06-22):

FW: high-speed test mode

gzweigle, 2024-06-22:
The piano multiplexes a high-speed ADC to result in an overall sample rate on the order of hundreds of microseconds.
However, if I fix all multiplexers and sample a single channel, the rate can be 10X faster with zero hardware changes.
Such mode is useful for design and test because can stream this single channel over Ethernet for offline analysis.
This test mode is done and in use. Creating an issue to remind myself to get it into a future release.

gzweigle, 2024-06-29:
When test_index in hammer_settings.cpp is >= 0, code enters the high speed mode.
Samples a single channel, set by test_index.  Turns off MIDI.
The single channel is streamed over Ethernet for offline analysis.
Tested at > 30,000 samples per second.
Useful for algorithm development and analyzing performance and accuracy tradeoffs, when sampling at the normal lower rate.
Also, for understanding piano action mechanical dynamics.

Closed 2024-06-29.

Thread 60 (2024-06-22):

FW: calibration tiny clipping

gzweigle, 2024-06-22:
Because of small nonidealities, the calibration can result in a small amount of clipping. Happens randomly. Does not effect piano when playing. But is annoying for offline analysis.
Add a small scale factor to give a little extra headroom.

gzweigle, 2024-06-29:
fixed clipping

Closed 2024-06-29.

Thread 62 (2024-06-23):

DOC: Using non-resistive pedals

gzweigle, 2024-06-23:
The IPS is setup for passive, resistive pedals.
If using an active pedal and do not want to have the PLS PCB, then do not solder R23, R25, and R28.
This issue is created to change the PLS documentation.

gzweigle, 2024-06-24:
Changes to following:
https://github.com/gzweigle/DIY-Grand-Digital-Piano/blob/main/hardware/releases/ips20/ips20_bill_of_materials_0.txt
https://github.com/stem-piano/stem-piano-g-main/blob/main/documentation/assembly_manual.md
https://github.com/stem-piano/stem-piano-g-main/blob/main/documentation/component_manual.md

Also I added a jumper to the growing list of IPS 2.1 enhancements:
https://github.com/gzweigle/DIY-Grand-Digital-Piano/issues/52

Closed 2024-06-24.

Thread 63 (2024-06-29):

FW: nonlinearity in piano vs test setup

gzweigle, 2024-06-29:
I have made progress improving note-to-note accuracy.
However, a recent test indicated that the sensor nonlinearity correction is better in the offline linear actuator test setup than when installed in the action.
This could have been a test or data collection issue.
Creating an issue so I don't forget to investigate when have time.

gzweigle, 2024-07-07:
Details of calibration including what it can and cannot correct will be covered in the technical paper:
https://github.com/gzweigle/DIY-Grand-Digital-Piano/issues/73

Closed 2024-07-07.

Thread 64 (2024-06-29):

DOC: hammer oscillation modes

gzweigle, 2024-06-29:
While working on velocity algorithm improvements, got sidetracked studying the higher-speed (33Ksps) hammer position samples that are streamed over Ethernet.
Seeing several types of oscillations. This is in addition to the normal hammer motion.
One oscillation category is due to the piano structure vibrating.
The other(s) is(are) still a mystery.
Once finish investigation, document so that offline hammer motion analysis algorithms can compensate.

gzweigle, 2024-07-07:
hammer oscillation mode analysis will be covered in the technical paper:
https://github.com/gzweigle/DIY-Grand-Digital-Piano/issues/73

Closed 2024-07-07.

Thread 66 (2024-06-30):

HW: sca part inconsistence

davidedelvento, 2024-06-30:
The BOM lists `U1` as `REF6025` but kicad lists it as `REF6030`

gzweigle, 2024-07-01:
Good question.
The part comes in variants 2.5V, 3.0V, 3.3V, 4.1V, 4.5V and 5.0V.
Probably when I did the schematic I was thinking 3.0V would work. However, that made VCE across the CNY70 too small.  All my documentation in stem piano repo is for 2.5V.
For your sensors you may be able to use a 3.0V or even 3.3V (check the amp range) as the reference value.  The higher the reference the better for signal.

I added a comment to hardware README files that the bill of materials wins if different than schematic.

davidedelvento, 2024-07-10:
I am not sure I understand the problem of `Vce` becoming too small when using an `U1` which provides a higher voltage.

Assuming that `Vce` is `5V` minus what `U1` provides and comparing Fig.3 of https://www.sparkfun.com/datasheets/Robotics/QR_QRE1113.GR.pdf with Fig.8 of https://www.vishay.com/docs/83751/cny70.pdf it appears indeed that `3.0V` might be marginally better.

But looking at the characteristics tables I don't see any other differences. Given the complexities of asking the vendor to manufacture some boards with one part and some others with another part, I'm tempted to let everyone take the `2.5V` version. Do you think that would be a problem? I guess in the worst case I could try to desolder and replace it if necessary (it would be a painful thing to do, but not impossible, as far as I can tell...)

gzweigle, 2024-07-11:
Yes, for HPS, vdd=3.3 and with vref = 2.5 the difference (vce) is 0.8 volts when hammer is at stop.
If vdd > 3.3, vref can be bigger.
I agree vref=2.5 for all boards is simpler.
Select ACE resistors so the output is 0 to 2.5v as hammer goes from rest to stop.

gzweigle, 2024-07-13:
1. Yes.

Vdd is an input to the HPS. For HPS 0.8, Vdd is the voltage difference between pins 1 and 2 of J0.

The HPS 0.8 is designed to receive 3.3V for Vdd.

2. Yes.

For example, with the resistors in the HPS 0.8 parts list, HPS 0.8 will output a voltage near 0 when the hammer is at rest and a voltage of near 2.5V when the hammer is at the stop bar.

Therefore, I selected REF6025 for the ADC reference since 2.5V matches the maximum output of the HPS 0.8.

3. This one is a little more complicated to answer:

REF6030 will also "work" with HPS 0.8. In this case, when HPS 0.8 is at its maximum output of 2.5V, the ADC will output 2.5/3.0 of full scale.  The full scale of ADC is not used.  This gives up some noise margin.  But the piano will "work".

What didn't work was sizing the resistors on HPS 0.8 so that it outputs 3.0V when hammer is at the stop bar. In this case, the voltage drop across the CNY70 was too small (3.3-3.0).

4. Not sure I understand but if the interest is to use REF6030 for all boards, it will also "work" for the HPS 0.8, with the caveat that these sensors will not use the full range of the ADC.

davidedelvento, 2024-07-14:
Thanks, this is extremely helpful, now I understand everything (and I have been able to run some tests).

I now also understand better why you wanted to put potentiometers in some of these designs. There is a key-to-key variability which (upon inspection and testing) is due to the different reflectivity of the hammers. That, compound with the different brightness that can be achieved with different currents at the LEDs make settling to a definitive answer a bit tricky. The QRE1113 can easily reach 3.05V when energized around 3.3V if the target is "shiny" enough (e.g. white paper, new hammers). On the other hand, a less reflective target (e.g. old hammers, even after filing them to make them very white) can stay easily under 2.5V

Puzzlingly, that maximum value does not change when changing the value of the bias resistor on the phototransistor (the non maximum achieved with a old hammer does). As such, I am tempted to have a 6030 installed -- but I fear they would get confused and ship those to Europe and give me the 6025 instead, so I am settling on the 6025 to begin with and then I will figure out some way of "voicing" the hammers to achieve the maximum range.

Thanks

Closed 2024-07-01.

Thread 67 (2024-06-30):

HW: kicad file for IPS board missing sockets for Teensy

davidedelvento, 2024-06-30:
This is probably historical since earlier to envisioned soldering the Teensy on, but better having sockets.

gzweigle, 2024-07-01:
When I created the schematic for IPS I didn't realize that using a symbol for both Teensy and SCA would later cause problems with specifying the headers. So, instead of redoing the schematic, as a workaround, I had decided to just specify the sockets in the bill of materials:
https://github.com/gzweigle/DIY-Grand-Digital-Piano/blob/main/hardware/releases/ips20/ips20_bill_of_materials_0.txt.
Because of the workaround, I am going to close this issue. Feel free to re-open if the answer isn't sufficient. However, unless this change is a showstopper for creating boards, it will be a very low priority.  I will also add to the IPS 2.1 project to-do.

Closed 2024-07-01.

Thread 68 (2024-07-01):

HW: missing kicad file for the ACE board

davidedelvento, 2024-07-01:
Ditto

gzweigle, 2024-07-01:
Added.

davidedelvento, 2024-07-01:
Is it intentional that these are for kicad v8 whereas everything else is for kicad v7? The incompatibility between different versions of kicad is frustrating...

gzweigle, 2024-07-01:
Agree. I've been thinking about adding v8 version to repo for all boards. Your comment motivated me to give it a try.

Closed 2024-07-01.

Thread 69 (2024-07-01):

HW: add KiCad v8 for all boards

gzweigle, 2024-07-01:
Project scope:
- Add KiCad v8 for all existing hardware.
- Keep KiCad v7 as well.
- Specify in repo which boards were built and tested with which KiCad version. This enables optionally making boards based on the version that was fabricated and tested.
- Fix errors and warnings due to KiCad library and other changes.
- Validate schematic changes by first running PCB DRC on existing (v7) PCB vs updated (v8) schematic before updating the PCB to v8.
- Goal: when fabricated, PCB is identical to v7.

gzweigle, 2024-07-05:
All KiCad 8 are now in *_v1 folders.
See
https://github.com/gzweigle/DIY-Grand-Digital-Piano/blob/main/hardware/releases/README.md
for explanation of numbering system (it isn't perfect but its backwards compatible with existing before I realized the KiCad challenges).

Closed 2024-07-05.

Thread 70 (2024-07-04):

HW: ACE board pins incorrectly set up all on the same side

davidedelvento, 2024-07-04:
In KiCad.

A picture is worth 1000 words

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

see how that mismatches the picture of the actual thing which has some things on one side and some on the other

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

gzweigle, 2024-07-04:
I don't know how to tell KiCad 3D Viewer Through-hole model Appearance to put on front or back.
Almost done with KiCad v8 update all circuit boards - if I figure out the 3D viewer appearance setting, will include that too.

davidedelvento, 2024-07-04:
> I don't know how to tell KiCad 3D Viewer Through-hole model Appearance to put on front or back.

Just to be clear that is not a matter of appearance in the 3D viewer, it's matter of fabrication error. As is, everything is placed on the top and nothing on the bottom, and if it is sent to fabrication it will come assembled as in the 3D viewer (i.e. incorrectly).

See the `aceA00-bottom.pos` file for detail:

```
### Footprint positions - created on 2024-07-04T11:35:51-0600 ###
### Printed by KiCad version 8.0.3
## Unit = mm, Angle = deg.
## Side : bottom
# Ref     Val       Package                PosX       PosY       Rot  Side
## End
```

To select the actual placement, go into the properties of the part (shortcut `E` once the part is selected in the GUI) and pick front or back as placement. Let me see if I can make a PR for this.

davidedelvento, 2024-07-04:
I made #71 trying to fix this issue (hopefully I did not cause other trouble....)

davidedelvento, 2024-07-04:
Same problem with the SCA board, attempted fix in PR #72

gzweigle, 2024-07-04:
> Just to be clear that is not a matter of appearance in the 3D viewer, it's matter of fabrication error

Good point. To fix this I am changing the footprint silkscreen so that it is on the bottom of board. For both SCA and ACE circuit boards. And to do that, I am in the process of revising the ACE from 0.0 to 0.1 and the SCA from 0.0 to 0.1.

I will also change the placement instructions as you note above. For consistency with how I am organizing the GitHub files, these revised PCB will be in new subdirectories which I am creating.

Also, FYI to address KiCad 8 issue I am creating new directories under the original PCB directories, and keeping the original with KiCad 7. I want to keep the original KiCad 7 files in the original directories visible (not buried in github history) because those are what were fabricated and tested... so far.

Thanks!

gzweigle, 2024-07-05:
Because this was a visible board change, I incremented the board version number.
https://github.com/gzweigle/DIY-Grand-Digital-Piano/tree/main/hardware/releases/sca01
https://github.com/gzweigle/DIY-Grand-Digital-Piano/tree/main/hardware/releases/aceA01
I also fixed an unrelated label error on ace version 0.0 and removed the ground plane because it doesn't add much value for this board, but it created a large surface for the soldering to heat which made soldering annoying.
I plan to build and test this board to makes sure I didn't break anything.

davidedelvento, 2024-07-05:
> I also fixed an unrelated label error on ace version 0.0 and removed the ground plane because it doesn't add much value for this board

I think the ground plane may add a bit of EMI protection, even though at the frequencies we are dealing with is probably marginal/irrelevant?

gzweigle, 2024-07-05:
Yeah.
Note that the larger SCA and IPS both have ground planes.
For the interposer the runs are very short and the signals relatively slow.
I could make a version (0.2) with the ground plane too if interested.

Closed 2024-07-05.

Thread 74 (2024-07-13):

HW: pedal jack cannot be found

davidedelvento, 2024-07-13:
You wrote "if" in https://github.com/gzweigle/DIY-Grand-Digital-Piano/issues/52#issuecomment-2225571769

Unfortunately, I am unable to find anything suitable and that is stopping progress on https://pianoclack.com/forum/d/1510-diy-electronic-purchase/

Can you please share the part number you used?

gzweigle, 2024-07-13:
Good point that the information in ips20_bill_of_materials_0.txt is not enough.  I will add more details.

Note that I just tried taking the description from the ips20_bill_of_materials_0.txt, and put it into a web search.
"uxcell Audio 6.35mm"
And it returned multiple sources to buy.

davidedelvento, 2024-07-13:
Thanks.

Yes, I did the same search, but unfortunately returned a large number of ebay/amazon/aliexpress results which are not specific product but something without a part number that I could in the order (I did not check them all, but I checked a large number of them and none had a part number). Moreover, many of them had different pin locations which would not match the PCB (as you wrote in that other issue)

I did the same search on Mouser, Digikey etc and that did not return anything. Tweaking the search terms I was able to find something okay (right socket and right number of pins) but none had a footprint compatible with the PCB.

davidedelvento, 2024-07-13:
Maybe this? Not completely clear to me if the footprint is the appropriate one: https://www.mouser.com/ProductDetail/CUI-Devices/SJ-63062A

gzweigle, 2024-07-14:
This in Amazon is it

uxcell 6.35mm 1/4 Inch 3Pin Mono Jack Panel Mount PCB Connectors Metal 6.35mm Headphone Socket Audio Stereo Connector

It is black with red along bottom.

I will put more info in repo too.

davidedelvento, 2024-07-14:
Thanks, but you did not post the link. The first hit is https://www.amazon.com//dp/B00X77SADC/ -- is that the one? It has several bumps in the bottom (probably for slots in the PCB? does it work even if the PCB does not have the slots?)

I will try adding such Amazon part to the order, but given how picky the vendor has been with not exactly part-numbered components (even for pin-headers!!!) I think they will balk at it. In such a case I will order it without and I'll let @AkariProd solder his own ones.

gzweigle, 2024-07-14:
yes that looks right.  Its really easy to solder.

And, yes it works with the slots. Stands the part up off the PCB slightly but the pins are so long they still go through the PCB by a good 1 millimeter.

davidedelvento, 2024-07-14:
Sounds great thanks. As far as I am concerned, this issue could be closed, not closing it myself in case you want to consider including the link in the BOM.

gzweigle, 2024-07-21:
updated documentation

Closed 2024-07-21.

Thread 75 (2024-07-13):

HW: pedal resistors clarification

davidedelvento, 2024-07-13:
The BOM contains the lines

```
R23,    4700 ohms,             0805,       ERA-6AED472V,         No,            0.50,        0.125W. 5% tolerance or better. For pedals. Install if using passive pedals.
R25,    4700 ohms,             0805,       ERA-6AED472V,         No,            0.50,        0.125W. 5% tolerance or better. For pedals. Install if using passive pedals.
R28,    4700 ohms,             0805,       ERA-6AED472V,         No,            0.50,        0.125W. 5% tolerance or better. For pedals. Install if using passive pedals.
```

For the group order of https://pianoclack.com/forum/d/1510-diy-electronic-purchase/ some people plan to use passive pedals and some people plan to use active ones (i.e. just CNY70 or QRE1113 sensors like the hammer ones).

Do I understand correctly that if these resistors are installed the active pedals won't work correctly?

Assuming that is the case, consider that there are `16*6=96=88+8` channels, i.e. 8 more than needed for keys only. Given that the pedals use three channels, would it be possible to use 3 channels for the passive pedals and 3 channels for the active ones (and we still have 2 to spare) and avoid this hardware complication?

gzweigle, 2024-07-13:
Will active pedals use the quarter inch jack inputs?

The reason I ask is because:
The quarter inch jacks connect to header J46 and they don't connect to anything else.
The resistors R23, R25, and R28 connect to the quarter inch jack outputs and these resistors don't connect to anything else.
To use quarter inch jacks, one uses a ribbon cable to connect J46 to one of the 96 inputs along the back of the PCB.

If active pedals connect to one of 96 inputs, and do not use the quarter inch jacks, then:
Install the resistors R23, R25, and R28.
And:
(a) Those using passive pedals use the quarter inch jacks.
(b) Those using active pedals connect directly to any of the 96 inputs along back of PCB.

Will that work?

davidedelvento, 2024-07-13:
No active pedals (at least the ones I have in mind) will use the pins like keys.

What you have designed sounds great and would work great, thanks.

Closing the issue.

Closed 2024-07-13.

Thread 76 (2024-07-13):

HW: Pedal resistors

davidedelvento, 2024-07-13:
This is probably leftover from #54 -- the BOM states 10 Ohm for R22 R26 and R29. But KiCad still has 10 kOhm. I am proceeding assuming that the BOM is correct, but please confirm.

gzweigle, 2024-07-13:
Correct 10 ohms.

davidedelvento, 2024-07-14:
Awesome, thanks. Not closing this issue since you may want to fix the value in KiCad.

gzweigle, 2024-07-21:
Documentation - use bom not schematic so we're good.

Closed 2024-07-21.

Thread 77 (2024-07-13):

HW: fuses

davidedelvento, 2024-07-13:
I understand that fuses are just one level of protection and they might or might not work for the purpose, so with all the obvious disclaimers of not taking you liable for anything, this being all at my risk etc etc, I would like to ask your opinion regarding these options (by the way, I would love for the hold and trip currents to be closer, but they aren't)

* For F1 use a 6V, 3.8A (hold), 8A (trip) fuse such as https://www.digikey.com/en/products/detail/bourns-inc/MF-USML380-2/7394484  and for F2 use a 6V, 1.9A (hold), 5A (trip) fuse such as https://www.digikey.com/en/products/detail/littelfuse-inc/MICROSMD190LR-2/3743342 (by the way all SMT fuses seem to be "obsolete" on digikey)
* For both F1 and F2 use the first option above
* For either or both F1 and F2 use a 0 Ohm resistor instead

gzweigle, 2024-07-14:
I clarified the documentation.
We don't know what power supply people will use.

gzweigle, 2024-07-14:
You could leave them off and have individuals decide based on their system.
Its a fairly large 1210 footprint.
That is the direction I changed the documentation.

gzweigle, 2024-07-27:
Added F2 to parts list
https://github.com/gzweigle/DIY-Grand-Digital-Piano/blob/main/hardware/releases/ips20/ips20_bill_of_materials_0.txt

gzweigle, 2024-07-27:
Also, I made a video on replacing a surface mount fuse and put the link to video in documentation here:
https://github.com/gzweigle/DIY-Grand-Digital-Piano/tree/main/hardware/releases/ips20

Closed 2024-07-27.

Thread 78 (2024-07-14):

DOC: Cut Teensy 5V PAD

gzweigle, 2024-07-14:
Document in all instructions to cut the 5V pad per:
https://www.pjrc.com/teensy/external_power.html

gzweigle, 2024-07-14:
Already made the change but create issue so it is tracked at a visible level.

Closed 2024-07-14.

Thread 79 (2024-07-14):

DOC: ribbon cable error

gzweigle, 2024-07-14:
Track down a persistent small coupling error on adjacent notes.
It is the ribbon cables.
Update assembly documentation.

gzweigle, 2024-07-14:
Documentation is updated in stem-piano-g repo

davidedelvento, 2024-07-14:
Yeah, ideally the ground and signal cables should be twisted around each other as I described at https://pianoclack.com/forum/d/637-build-your-own-hybrid-piano-step-four-the-cables -- unfortunately that's a pain, but I'm working on building a machine to make that cable-making easier (of course that link is for when I used a different electronics, but still...)

The good news is that there exist pre-twisted cables, which I am still exploring about. The bad news is that it's a niche product with limited options (e.g. length of twisted section, pitch of the cables, etc) which make it hard to adapt to our needs. As I wrote in that page above, one should design the (mechanics of the connectors of the) sensorboards and ADC boards based on cable availability, rather than the other way around... Well, maybe next version.

One example of such cables: https://www.digikey.com/en/products/detail/3m/1700%2F10%2520100/9479266

Closed 2024-07-14.

Thread 80 (2024-07-21):

FW: doubles for calibration

gzweigle, 2024-07-21:
changed so that 1/log() is more accurate

gzweigle, 2024-07-21:
fixed

Thread 83 (2024-07-27):

HW: Option to power the LEDs via external constant current supply

davidedelvento, 2024-07-27:
This is potentially related to #40 and #14 and definitely to https://github.com/gzweigle/DIY-Grand-Digital-Piano/tree/main/hardware/releases/aceA00 as well as https://github.com/davidedelvento/piano-conversion/tree/QRE1113GR-4x-four-holes/hardware/sensorboards/2040-centered-4x-QRE1113GR

In brief: LED output depends on the current that flows into them, regardless of the voltage drop that the LED incurs in. Device-to-device variability, and other factors, make the voltage drop different in different LEDs, which makes a constant-voltage power supply (the one currently used in the design) a bit less stable and a bit more subject to calibration and calibration drifts.

A simple off-the-shelf linear regulator such as the IHB120-0.2 (if one would like to power all the LEDs in a single strip) or lower voltage such as the HB48-0.5-AG (spitting the LEDs in multiple strips, probably better for maintenance) can be used to very stably power a voltage-to-current regulator such as the CL220N5-G which is inexpensive and can be used either for single strip or for multiple strips in parallel as described in its datasheet (Fig 3-5).

This setup would guarantee a more constant LED-to-LED brightness as well as a more stable in time brightness (since the residual ripple is extremely low). Moreover, there is no need for current-limiting resistors, and so if they are left out of the board no power dissipation on them (however the linear voltage supply will have an efficiency of just about 60%, but that is already similar to what is installed on the IPS board).

Of course all of this could be implemented on the IPS itself rather than as an external solution as described here

gzweigle, 2025-04-26:
This is an interesting idea.
Will close because if I decide someday to revisit the sensor design, I will review all historical issues anyway whether open or closed.

Closed 2025-04-26.

Thread 86 (2024-09-02):

FW: increase hammer dsp filter length

gzweigle, 2024-09-02:
analysis shows that a slightly longer filter is better able to attenuate certain vibrational modes
the impact on latency is less than a millisecond

gzweigle, 2024-09-02:
done

Closed 2024-09-02.

Thread 88 (2024-09-05):

DOC: power jumper

davidedelvento, 2024-09-05:
In your latest video you mention very quickly the "power jumper" and repeatedly say "see links below for more info". Below there are only link to the github repos. The power jumper is not mentioned anywhere in text that github can find. The only reference I could find is in the picture of the page https://github.com/stem-piano/stem-piano-g-main/blob/cadb8c2ac602357a89b7d46fda0e3810b8dbe8d5/documentation/users_manual.md -- but as far as I can tell it has been removed on more recent version of that picture.

Worth adding that info to the text of the page https://github.com/stem-piano/stem-piano-g-main/blob/cadb8c2ac602357a89b7d46fda0e3810b8dbe8d5/documentation/construction_subsections/subsection3a_circuit_board_assem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 in my opinion.

I thought that there was another thing missing, but I cannot rewatch the video now and I don't recall, so if you have time maybe a quick check if everything you wrote in all the boxes you included in the video can be actually be found on the docs.

UPDATE: that picture is still used in the most recent version of the documentation at https://github.com/stem-piano/stem-piano-g-main/blob/main/documentation/users_manual.md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 but my point remains that it's a hard to find and not descriptive about what is needed (okay, as little as "purchase such and such jumper and place it there", but still...)

gzweigle, 2024-09-05:
Sure enough, the documentation is missing.
Added with commits "issue 88 - power jumper".

Also noting that this issue is number is also the number of keys on a piano!

Closed 2024-09-05.

Thread 89 (2024-09-05):

HW/DOC: cable crosstalk

davidedelvento, 2024-09-05:
At https://github.com/stem-piano/stem-piano-g-main/blob/main/documentation/component_manual.md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 you mention the crosstalk across different channels due to use of ribbon cables. I would like to reproduce the problem and test mitigation strategies such as using the twisted cables (which I think I mentioned to you earlier) and others.

To ease my work and help making an apple-to-apple comparison, can you please share the procedure you used to measure this crosstalk (e.g. playing one key and looking at the signal from a nearby channel while everything was on the piano rather than on the table)? If you still have it around, can you please also share the data, so I can check if in my different (as you know) setup I can reproduce a comparable baseline before I try to improve on it?

TIA!

gzweigle, 2024-09-28:
... if only I could remember :)

gzweigle, 2025-04-23:
https://youtu.be/yqkRKSGX6kw?t=229

Closed 2025-04-23.

Thread 90 (2024-09-08):

HW: discussion related to IPS 2.1

davidedelvento, 2024-09-08:
To avoid making issue #52 a giant discussion, let me discuss here some things which I think you could/should do for the next version

1. mounting holes -- they are too small, and make the IPS board very flimsy, even just mounting is, especially when attaching/detaching cables and other boards. I know one should not do these things too often, but still... I strongly recommend you make the holes at least M3 and ideally M4 size
2. cabling -- in my brief experience so far, the situation is worse than I thought. Perhaps a mitigation strategy could be to use ubiquitous, inexpensive and high quality ethernet cables, rather than ribbon. Each cable such as https://en.wikipedia.org/wiki/Ethernet_over_twisted_pair would carry signal for 4 sensors. I know your current design involves single sensor boards, but I think you should consolidate them in groups of 4, which is extremely convenient for assembly and regulation (we can have that conversation separately). Even if you want to keep the HSP for single sensors, still grouping the signals in an ethernet cables at the IPS would make things much easier (and a split can be easily made near each sensor if you want to leave them unchanged). This is possible with an interposer board, obviously, but I think it would be ideal if made straight on the IPS board, to minimize size, cost and EMI.
3. In issue #52 you wrote

> Quarter inch jack interposer board

4. not sure if you mean the same thing I mean for "interposer". For me that word means a PCB that is placed in between two things, both electrically and (most importantly) physically. Here I think the best solution would be a separate board (or even just panel-mount jacks!) with some cabling (ribbon?) going to the IPS, which would have only header pins. Same for most things, including MIDI, Ethernet (should use twisted pairs, but probably the rate is slow enough that it might not matter), power, etc.
5. Related to this, and perhaps you intend to do that but did not say in the list, I think making the IPS much smaller would be better, both for convenience of installation (it is really hard to find that space inside the cabinet without interfering with other things, even more so when using two of them for the damper sensors) and for cost. In my view the IPS should have headers for the Teensy and the SCA, then the multiplexers, and the headers (ideally ethernet-like jacks) for the sensors. Maybe the switches/buttons/LED, and that's it. Everything else should go with few more headers so that it can be installed in a separate location (particularly the display)
6. You also wrote

> Move CAN connector to back of board.

7. I don't understand this, and I strongly oppose it. Dealing with the board as is, it's already difficult. Having headers on the back of the board too would be a nightmare (but perhaps I misunderstood what you meant by "back" and you did not really meant the other side of the board, just a different location?)
8. I think I had a couple of other things, but I don't recall them now and I think they were minor compared to these ones

gzweigle, 2024-09-09:
(2) - agree, a better solution is needed.  The ACE boards help a little but not sufficiently.

(4), (5) - this would be interesting and very flexible... I will think about it. Maybe it is called IPS 3.0 too. Saves at least 1.5 inches of width.
Note that with present board, future SCA design variations can optionally fill the entire TFT PCB space. I designed it this way after considering the mm^2 required for 6 parallel ADC on a new data acq card. So that is why I was ok with the quarter inch jack real estate.

However, taking the modular concept one step further, I could in theory put each function on its own board.
1 board for 96 analog inputs
1 board for data acq
1 board for processing
1 board for display and switches
1 board for pedals
1 board for data i/o
1 board for display
Connect them together with Ethernet cables (as you noted).
Then, everything is highly modular, incredibly flexible/expandable, and minimally small.

davidedelvento, 2024-09-14:
> Note that with present board, future SCA design variations can optionally fill the entire TFT PCB space. I designed it this way after considering the mm^2 required for 6 parallel ADC on a new data acq card. So that is why I was ok with the quarter inch jack real estate.

Would this be to reduce latency / scanning time? If so, rather than having larger SCA and IPS (which are expensive to make) why not have multiple boards like you currently have for hammer and damper sensors? Most PCB houses have a minimum order of 5 boards anyway, so having more boards smaller rather than one board larger makes financial sense (and ease the logistics of cabling since each board could be attached only on (say) an octave or two. Of course a communication protocol better/faster than the CAN bus might be needed.

Thread 92 (2024-09-09):

SW: compilation error

davidedelvento, 2024-09-09:
```
/home/davide/Arduino/src_hammer/src_hammer.ino: In function 'void setup()':
/home/davide/Arduino/src_hammer/src_hammer.ino:166:7: error: 'class TftDisplay' has no member named 'Clear'
  166 |   Tft.Clear();
      |       ^~~~~

exit status 1

Compilation error: 'class TftDisplay' has no member named 'Clear'
```

fixed by
```
--- a/firmware/releases/ips2_hammer/src_hammer.ino
+++ b/firmware/releases/ips2_hammer/src_hammer.ino
@@ -65,7 +65,9 @@ Switches SwSCA1;
 Switches SwSCA2;
 TestpointLed Tpl;
 Timing Tmg;
+#ifdef TFT_INSTALLED
 TftDisplay Tft;
+#endif

 MIDI_CREATE_INSTANCE(HardwareSerial, Serial1, mi);
 uint8_t Midi_Buffer[MIDI_BUFFER_SIZE];
@@ -97,8 +99,10 @@ void setup(void) {
   if (Set.debug_level >= DEBUG_STATS) {
     Serial.println("Beginning hammer board initialization.");
   }
+#ifdef TFT_INSTALLED
   Tft.Setup(Set.using_display, Set.debug_level);
   Tft.HelloWorld();
+#endif

   // Initialize the nonvolatile memory.
   // Initialize early in case any setup() uses storage.
@@ -163,7 +167,9 @@ void setup(void) {
     Serial.println("Finished hammer board initialization.");
   }
   delay(2000);
+#ifdef TFT_INSTALLED
   Tft.Clear();
+#endif

 }

@@ -300,7 +306,9 @@ void loop() {

     if (Set.test_index < 0) {
       // Run the TFT display.
+#ifdef TFT_INSTALLED
       Tft.Display(switch_tft_display, calibrated_floats, damper_position);
+#endif
     }

     // Debug and display information.
@@ -317,4 +325,4 @@ void loop() {

     Tpl.SetTp8(false);
   }

```

gzweigle, 2024-09-09:
thanks, and I pushed a commit that fixes

Closed 2024-09-09.

Thread 93 (2024-09-09):

FW: How to design a MIDI USB device for piano

gzweigle, 2024-09-09:
Location for tracking research.

davidedelvento, 2024-09-09:
These should provide some related info

* https://forum.pjrc.com/index.php?threads/teensy-4-1-adafruit-tinyusb-support.64627/
* https://forum.arduino.cc/t/library-hell-specifically-tinysub-and-midi-in-general/923078/2

and most importantly

* https://www.pjrc.com/teensy/td_midi.html

I've done this on a RPi Pico v1, which is an extremely limited board, so on the Teensy it should not be that hard...

davidedelvento, 2024-09-15:
Looks like this is super-easy, simply

* in the menu Tools -> USB select MIDI + serial rather than only serial
* in line https://github.com/gzweigle/DIY-Grand-Digital-Piano/blob/main/firmware/releases/StemPianoIPS2/src/midiout.cpp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 just add `usbMIDI.sendNoteOn(midi_note, velocity_potentially_muted, midi_channel_);`
* and equivalently a couple of lines below with `sendNoteOff`

And should work out of the box. I will try asap (hopefully tomorrow), but I thought to let you know beforehand in case you wanted to try it yourself first.

GalhardoLab, 2024-09-15:
a - it is also necessary to find the instances of CC64, 66, 67 for the pedal messages.

b - there are some arduino midi-usb libraries is which it is possible to buffer several midi commands (maybe up to 16, but I have to double check) and dump them all at once with the same timestamp. This is helpful to send together notes that are triggered within the same scan cycle, thus avoiding a slight "broken chord" effect.

b1 - I am not sure if that arduino library is compatible with Teensy, nor if the teensy library is capable of the same...
b2 - I am not sure if this firmware has one master cycle scan, or if it is interrupt-like... If there is no scan cycle, the hold and dump approach does not make sense.

gzweigle, 2024-09-21:
I also edited the documentation.

Closed 2024-09-21.

Thread 94 (2024-09-14):

HW: polarity of the power supply

davidedelvento, 2024-09-14:
The silkscreen for the IPS should include a text saying if the + is inside or outside

gzweigle, 2024-09-28:
Added to the IPS 2.1 to-do list.

Closed 2024-09-28.

Thread 95 (2024-09-14):

HW: Label the LEDs

davidedelvento, 2024-09-14:
Add to the silkscreen of the IPS some short abbreviation of the meaning of the LEDs, per the description at https://github.com/stem-piano/stem-piano-g-main/blob/main/documentation/users_manual.md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

For example: proc, damp, strike, pedal

gzweigle, 2024-09-21:
I added a comment in the users manual that LED functionality is set by the firmware.

I'd prefer not to put any labels on the hardware that make assumptions about the firmware. However, I will add an item to IPS 2.1 issue to try and make space on PCB for someone to put stickers next to LED.

Closed 2024-09-21.

Thread 96 (2024-09-14):

HW: label inp and gnd on ACE

davidedelvento, 2024-09-14:
Label `gnd` or ground symbol instead of J4 and J9

Label 'inp' instead of J2 and J7

davidedelvento, 2024-09-14:
Or even better label `E` (for emitter) for J2 and J7 and `C` for collector J5 and J10. And now that I see it better, another cabling complication, it would have been better if the rows for E and C were adjacent, as they are it complicates my cable building a lot, I wish I had noticed beforehand.... Maybe for the next version?

gzweigle, 2025-05-04:
Working on damper sensor upgrades and investigated this. The rows match the rows on IPS which helps me keep everything straight.  I will add the idea to swap E and C to the IPS 2.1 list.

gzweigle, 2025-05-17:
> Working on damper sensor upgrades

Sure enough these labels would have been useful.  Adding to an upcoming manufacturing run.

gzweigle, 2025-05-18:
created ACE board version 0.2 with the power, ground, and signal labels.

https://github.com/gzweigle/open-hybrid-piano/tree/main/hardware/releases/aceA02

Closed 2025-05-18.

Thread 97 (2024-09-14):

FW: simplify Ethernet activation

davidedelvento, 2024-09-14:
According to https://github.com/stem-piano/stem-piano-g-main/blob/main/documentation/users_manual.md#ethernet ethernet data is sent when a key is held and pedal depressed. I see two problems with this approach:

* Can (and will!) be triggered involuntarily when playing. Probably not a bit deal, but still cycles wasted if unintended
* Hard to trigger during testing when pedal may not be available

I recommend switching to a procedure that uses ETHERNET_SEND_KEY as it is done for the damper board

gzweigle, 2024-09-28:
The software now sends all 96 analog inputs all the time.

I made a YouTube video showing the new functionality -

https://www.youtube.com/watch?v=AWMlzoCq9G0

Closed 2024-09-28.

Thread 98 (2024-09-14):

DOC: ethernet connection

davidedelvento, 2024-09-14:
It is unclear how ethernet connection is supposed to happen. I see three possible options:

* connection to a router with a regular cable (but then what if the router uses DHCP and assigns the board a different IP address than the configured one?)
* connection to the computer with a crossover cable or adapter (see https://en.wikipedia.org/wiki/Ethernet_crossover_cable for details) as it is typically done in these situations (in such a case the hardcoded IP address makes sense)
* connection to the computer with a *regular* cable, assuming that the crossover has happened on the IPS board itself

Any of these solutions would be totally fine, but it needs to be documented which one is the appropriate one (I have not tried it yet at time of writing)

gzweigle, 2024-09-28:
Added Ethernet connection documentation.

davidedelvento, 2024-09-28:
Oh, I see so now you send all keys rather than just 12, very nice, given that the bandwidth allow that!

More strictly on my own question, I studied Teensy hardware and software, and it supports *automatic crossover* so you basically connect it to either a switch or a computer directly, and its own firmware (not the one you wrote) interacts with its own hardware and automatically senses which lines are for transmit and which ones are for receive. So you can

* use any cable (normal or crossed)
* connect to anything (computer or switch) as long as it does *not* use DHCP but honors the IP one hardcodes in your firmware per your instruction

You might want to add this clarification too in the docs

gzweigle, 2024-09-28:
re-opening to remind myself to make this change

gzweigle, 2025-04-26:
Added info in users manual.

Closed 2025-04-26.

Thread 100 (2024-09-15):

DOC: make wiring order diagram more prominent

davidedelvento, 2024-09-15:
I was very familiar with https://github.com/stem-piano/stem-piano-g-main/blob/main/documentation/assembly_manual.md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 existence, but I was not sure of one thing so I wanted to check that.

I've spent 10 minutes finding it. I recommend making it more prominent, perhaps with a dedicated section, and for sure with a "Wiring" link in between 3. and 4. at https://github.com/stem-piano/stem-piano-g-main/blob/main/documentation/construction_manual.md

davidedelvento, 2024-09-28:
Related to this and to make the wiring job easier: would it be possible to change the wiring order in firmware and I mean in a random order?

Reason to ask: given the way that the hammers are grouped, it would be incredibly easier if I could (say) connect the IPS keys numbers 0 to 7 to what are piano keys 2 to 9 and then connect IPS8-15 to piano 10-17 and then IPS16-23 to piano 20-27 etc and then using an arbitrary IPS slot to connect the "loose" piano keys that I missed, in this example so far 0,1,18,19.

I am sure this is *possible*, it's just software obviously. The question is if this is possible by introducing a LUT and using it rather than direct assuming things, and if such a change would be small (handful of places) or massive (turn the whole code base upside down).

Assuming it is "small", would you accept a PR for such a change? I want to make my (and other people's) wiring life easier, but I don't want to diverge from your main code base

gzweigle, 2024-09-29:
I can make this change.  Because I can combine it with void SixChannelAnalog00::ReorderAdcValues(unsigned int *);

gzweigle, 2024-09-29:
Code is updated for custom changing wiring order in firmware.
See hammer_settings.cpp and also the commit diffs.
Let me know if this is what you needed.

Also I updated the wiring diagram documentation

Closed 2024-09-29.

Thread 101 (2024-09-28):

FW: damper board no longer compiles

gzweigle, 2024-09-28:
I've made some changes to hammer firmware and need to update the damper firmware.

davidedelvento, 2024-11-28:
Have you had a chance to look at this or not yet? If not, I may give it a stab during the weekend!
Thanks and happy Thanksgiving!

gzweigle, 2024-12-16:
This is still on my to do list.

I previously had the dampers working. But, after changing the mechanical, it presently uses the hammers to estimate the damper positions. This works so well, I have not taken the time to update everything.

davidedelvento, 2025-01-04:
> This is still on my to do list.

Thanks!

> I previously had the dampers working. But, after changing the mechanical, it presently uses the hammers to estimate the damper positions. This works so well, I have not taken the time to update everything.

Yeah but with my hammer (rather than shank) sensors, this is very important for my setup. Life got in the way, so I haven't finished wiring it yet and therefore I haven't even looked at the code either....

gzweigle, 2025-01-07:
ok I updated the code it now compiles.
next I will test it

gzweigle, 2025-04-26:
Updated damper board firmware with all previous and most recent feature enhancements from the hammer board firmware.

Closed 2025-04-26.

Thread 102 (2024-09-28):

HW: alternative power supply

davidedelvento, 2024-09-28:
Would you be interested in knowing more, perhaps in a PR, about my power supply strategy which I sketched at

https://pianoclack.com/forum/d/1621-build-your-own-diy-hybrid-piano-step-six-putting-it-all-together/10

I think that has clear benefits compared to your current one, including

* potentially have only two rather than 3 cables per sensor
* avoid the current limiting resistors (if you still have those in your current design)
* simplify wiring, and assembly, especially for people who want to use USB-MIDI, by removing the need for powering up the IPS separately
* maybe be more stable than your current design (not sure since I have not really studied yours, but I have studied mine :-) )

If you are interested, let me know how is it best for me to share what I have done. If you are not interested, simply close this issue, no offense taken, and if a casual reader cares they will find the link above and will be able to learn from there or contact me separately.

gzweigle, 2024-09-28:
What about putting it here?
https://github.com/stem-piano/sensor-systems

davidedelvento, 2024-09-30:
Sounds great. Let's continue the discussion [there](https://github.com/stem-piano/sensor-systems/pull/2)

Closed 2024-09-30.

Thread 103 (2024-09-28):

Magic damper_velocity_scaling

davidedelvento, 2024-09-28:
https://github.com/gzweigle/DIY-Grand-Digital-Piano/blob/f2202697138da32c7a9a854ba522e4d826138005/firmware/releases/ips2_hammer/hammer_settings.cpp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

Does it mean that one (==myself in this case, but anyone in general) needs to adjust this value to make it in that `[0,1]` for one's hardware? Two random damper events (ON/OFF) are far from being in that range

```
  key=1 pos_now=0.54 pos_then=0.42 velocity=2.43 threshold=0.50
DetectHammerStrike()  key=1 pos=1.000000 v_max=7.621892 v_inst=8.705567 repc=167 bufp=6
FixedScale(): velocity of key 1 is set at limit, orig velocity was 8.71.
MIDI note (22) index (1) velocity (127) is now ON.
AutoMute: simultaneous = 0 interval = 45596
AutoMute Activated - piano volume reduced for this note.
GetDamperEventData() - damper down
  key=1 pos_now=0.48 pos_then=0.57 velocity=-1.84 threshold=0.50
MIDI note (22) index (1) velocity (82) is now OFF.
AutoMute: simultaneous = 1 interval = 4
```

I understand that you probably meant `[-1,1]` since the damper velocity contains the sign of the direction of motion (you might want to update the comment for that). But even so, I'm well outside of that range with `velocity=-1.84` and `velocity=2.43`, is that going to be a problem?

gzweigle, 2024-09-28:
Looks like with a different hardware setup that the velocity is much larger.
Yes, use the velocity scale so that is in range [-1, 1].

gzweigle, 2024-09-28:
Also I fixed the comment.

Closed 2024-09-29.

Thread 104 (2024-09-28):

Use the same nomenclature in the firmware and in the documentation

davidedelvento, 2024-09-28:
I recommend doing this is for everything, but the thing I am struggling now is these switches:

https://github.com/stem-piano/stem-piano-g-main/blob/cfadfc73181cc4308970d7a02c034dba0a3c4c3f/documentation/users_manual.md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

According to my grep'ing there is no `sca_sw1_position2` nor `FREEZE_CAL_VALUES` anywhere in the firmware, so finding where things are happening is harder than it needs to be.

In particular, I have (and cannot) cabled all the keys yet. I notice many problems with my setup and I now suspect that the root cause of at least some is that I have not run (and cannot) the calibration, because I cannot trigger all keys without having all cables. As such, I wanted to change the code of the freeze the calibration and enable that mode anyway even if not all keys are calibrated, so at least I can proceed. I've performed the switch operation, but the LED remains flashing fast, and nothing changes, so perhaps I have not performed it.... Digging into the code and I am confident that I'll have it solved by the time you read this, but I still think a more consistent nomenclature will help those coming after :slightly_smiling_face:

gzweigle, 2024-09-28:
Good point that the documentation does not match the code names.

I added comments to src_hammer.ino.
The src_damper will be the same but I have not checked that in yet because of other compiler errors.

gzweigle, 2024-09-28:
As for calibration - each note calibrates instantly when it is pressed.  The light flashes fast until all 88 are calibrated. But once a note is pressed once, the note is calibrated.

However, the calibration can also get in the way when debugging.  Because it is adding an additional uncontrolled variable to the debugging process.

Here is an idea when trying to get individual keys working:  you could leave sca_sw1_position2 (FREEZE_CAL_VALUES) permanently on. This disables calibration.

Then, either:

- use the velocity scaling setting value to get the velocity in the correct range.

- or, edit six_channel_analog_00.cpp NormalizeAdcValues() and apply a temporary scaling right at the ADC output.  Apply it to normalized_float[].

Closed 2024-09-29.

Thread 105 (2024-09-28):

SW: Capture all hammers in software?

davidedelvento, 2024-09-28:
Current version (both release and research, as far as I can tell) of `get_hammer_data.py` still assume 12 notes rather than 96. Since you made that nice video, I assume you already have the code and simply have not pushed it yet.

Related to #97

gzweigle, 2024-09-28:
ah, ok I will fix this.

davidedelvento, 2024-10-14:
Guessing from the update to

https://github.com/gzweigle/open-hybrid-piano/blob/main/firmware/releases/StemPianoIPS2/src/network.cpp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

I tried this patch

```
diff --git a/software/releases/ips2_analytics/get_hammer_data.py b/software/releases/ips2_analytics/get_hammer_data.py
index 9f5d3b1..5b8f0bf 100644
--- a/software/releases/ips2_analytics/get_hammer_data.py
+++ b/software/releases/ips2_analytics/get_hammer_data.py
@@ -25,11 +25,10 @@
 # num_received_values must match number of sent values from the piano.

 # Convert encoded integers into original value.
-def convert_to_float(a, b, c):
+def convert_to_float(a, b):
     x  =  int(a)&255
     x |= (int(b)&255)<<8
-    x |= (int(c)&255)<<16
-    y = float(x) / 8388608.0
+    y = float(x) / 32768.0
     if y > 1:
         y -= 2
     return y
@@ -37,14 +36,15 @@ def convert_to_float(a, b, c):
 import socket
 import time

-file_length = 20000
-max_packet_size = 100
-num_received_values = 12
+file_length = 40000
+num_received_values = 88
+max_packet_size = num_received_values * 2
+

 # This computer's IP address. Must match value in Teensy.
-UDP_IP = FILL IN BEFORE RUNNING
+UDP_IP = "10.10.0.11"
 # Port number must match value in Teensy.
-UDP_PORT = FILL IN BEFORE RUNNING
+UDP_PORT = 4097

 client = socket.socket(socket.AF_INET, socket.SOCK_DGRAM)
 client.bind((UDP_IP, UDP_PORT))
@@ -63,7 +63,7 @@ for ind in range(0,file_length):
     # Data is sent as three 8-bit integers. Convert to [-1, ..., 1].
     data_float = []
     for k in range(0,num_received_values):
-      data_float.append(convert_to_float(data[3*k+0], data[3*k+1], data[3*k+2]))
+      data_float.append(convert_to_float(data[2*k+0], data[2*k+1]))

     # Write to file as a row of floats.
     # Write only the single note tested.
```

and a small slice of my data looks like

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

Is my patch or my sensing code to be completely broken?

gzweigle, 2024-10-15:
At first glance your patch looks like it should work.

However, just to be sure, I fixed the code. Tested it.  And, put an output file from my testing into the directory with the corrected code.

I created a new issue in case this one needs to stay open for understanding the output data.  However, if the fixed also resolves that, then I will close this issue.

davidedelvento, 2024-10-19:
An update on this. The code you committed is obviously more complete than my quick patch, but the problem I mentioned in my previous update was due to a bug in my plotting script :rofl: and after I fixed that even my earlier capture show decent data (which I still need to study to optimize capture)

I don't think you need to work more on this issue hence I'm closing it

Closed 2024-10-19.

Thread 107 (2024-10-10):

rename repository

gzweigle, 2024-10-10:
The repository name no longer reflects the path this project took.
From GitHub documentation, I can rename the repo and references to the original (including url) will still work.
Those with repo clones may need to reclone or set url.

gzweigle, 2024-10-12:
The repository will be renamed later today.

gzweigle, 2024-10-12:
The new repository name is open-hybrid-piano.

All references to original name automatically link to the new repository name.

For example, https://github.com/gzweigle/DIY-Grand-Digital-Piano/ now redirects to https://github.com/gzweigle/open-hybrid-piano/

davidedelvento, 2024-10-12:
Didn't you want to move it to stem-piano organization too?

davidedelvento, 2024-10-12:
FWIW, forks were automatically fixed too (and hopefully clones will do that on their own also, but I'll keep an eye for it).

See https://github.com/davidedelvento/DIY-Grand-Digital-Piano/tree/main (I did not do anything myself)

gzweigle, 2024-10-12:
> Didn't you want to move it to stem-piano organization too?

For now I have been putting the detailed documentation in stem-piano, with links back to open-hybrid-piano (new repo name) for source and issues tracking.

stem-piano I think scales better when we get millions of contributors :) but open-hybrid-piano has all the history.

davidedelvento, 2024-10-12:
My understanding was that you can change the "owner" (from yourself to the stem-piano "organization") keeping all the links and all the history, but in any case, either one works just fine for me :)

Closed 2024-10-12.

Thread 109 (2024-10-20):

DOC: how to proceed in debugging sensor data

davidedelvento, 2024-10-20:
With my sensors and my action (which you know are both very different than yours), I have a problem finding the appropriate calibration. I'm not asking for a fish, but to be taught to fish, which I can then make it into a PR for the documentation, so others can benefit too. I'm describing my problem just as an example: I speculate you went through something similar and so the actual question is "what steps would you suggest performing to debug similar issues". I know some people are mulling the option to use the system with different kind of sensors (maybe not even optical ones), so this would greatly help them too.

It feels like I am stuck at a note-on velocity of almost always 16. See for example this MIDI and corresponding ADC capture

```
note_on channel=1 note=24 velocity=16 time=0
note_off channel=1 note=24 velocity=23 time=0

note_on channel=1 note=24 velocity=16 time=0
note_off channel=1 note=24 velocity=50 time=0

note_on channel=1 note=24 velocity=16 time=0
note_off channel=1 note=24 velocity=84 time=0

note_on channel=1 note=24 velocity=16 time=0
note_off channel=1 note=24 velocity=79 time=0
note_off channel=1 note=24 velocity=4 time=0
note_off channel=1 note=24 velocity=0 time=0
note_off channel=1 note=24 velocity=2 time=0

note_on channel=1 note=24 velocity=16 time=0
note_on channel=1 note=24 velocity=34 time=0
note_off channel=1 note=24 velocity=10 time=0
```

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

In this example (which I unfortunately I forgot to separately timestamp on the MIDI capture part, given that real-time MIDI has no inherent timestamps) I had:

* only 5 hammer strikes of which 4 where with a keypress and one was with manual raise of the shank
* note that there are several `note_off` events after the 4th `note_on`. This is likely due to the fact that I grabbed the shank with my fingers and so I moved it in an "unexpected" way
* note that there are 6 `note_on` events, I manually grouped the last two together because that was my "manual" strike in which I did by moving the shank with my finger (no keypress involved), so that may be an actual double-strike. This way I was able to achieve a different-than-16 velocity
* `damper_threshold = 0.22` (otherwise the MIDI channel would be flooded by a continuous stream of `note_off` events)
* `hammer_strike_algorithm = 1`

and the following problems:

* velocity is stuck at always 16, regardless of how I make a keypress from ppp to fff
* with manual shank movement (even a relatively slow one, definitely slower than what a keypress achieves) I can get faster velocities, and occasionally a zero (which is different than `note_off` as far as I understand the code in the firmware)
* there are many more peaks in the data captured from the ADC than there are `note_on` events. This is really puzzling. I mean, the ADC values may be too noisy for a gazillion of reasons, so in itself is somewhat okay. But then how can the code correctly identify the moments (if not the velocity) if the hammer strikes??!

I speculate that the hammers move too fast (my sensors are right under the felt, as compared to yours near the flange) and therefore something in the code is too slow to keep pace and measure them fast enough for sensing velocities faster than MIDI 16. Perhaps something else (e.g. some integer conversion) forces the velocity to not be slower than 16 either (given the range of ADC measurements), and so it's stuck there.... unless I move an hammer with my hand, which is slower enough to be measured and hence other velocity values are generated. Pure speculation here, which I could confirm if there is a quick debug setting somewhere to stop the multiplexing and go "full throttle" on one note only. Is there such an option?

Probably confirming the speculation above, but I tried changing various constants with `_scaling` and `_threshold` and the algorithm (`0` or `1`). None of those changes modified anything with regard to this behavior.

gzweigle, 2024-10-20:
I always debugged with calibration off.  One less variable.

Here is some data that could help.  I moved a sensor to be over the hammer.

Attached is:

(1) A picture of the test setup.

(2) Measured values (received over Ethernet) for a very slow (manual move hammer), slow (keypress), and fast (keypress) hammer strike.

(3) A picture of plot of position and velocity.

Observations:

(A) The sensor does not pick up the hammer until it is close to the sensor. So the hammer position data is very nonlinear.

(B) There are less samples due to the faster motion (traveling 40mm at hammer vs 5 mm at flange).  But back-of-the-envelope and looking at this attached data, the 300us sample rate may be ok.

(C) The velocity in attached plot is about 2X for the fast strike compared to the slow strike.  This quick test didn't test if I actually played with 2X the velocity.

[a0_fast_strike.txt](https://github.com/user-attachments/files/17448235/a0_fast_strike.txt)
[a0_manual.txt](https://github.com/user-attachments/files/17448236/a0_manual.txt)
[a0_slow_strike.txt](https://github.com/user-attachments/files/17448237/a0_slow_strike.txt)

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

gzweigle, 2024-10-20:
The results I just shared is with calibration off.

gzweigle, 2024-10-20:
Octave code to recreate my plots.  The zeros in the filter are just to smooth things out.  They aren't necessary.

clear;

x_slow = load("a0_slow_strike.txt");
x_fast = load("a0_fast_strike.txt");

v_slow = filter([1 0 0 0 0 0 0 0 -1],[1],x_slow);
v_fast = filter([1 0 0 0 0 0 0 0 -1],[1],x_fast);

t = [0:length(x_slow)-1]*300e-6;

figure(1);
subplot(2,2,1);
plot(t, x_slow);
grid;
title('position, slow');
xlabel('seconds');

subplot(2,2,3);
plot(t, x_fast);
grid;
title('position, fast');
xlabel('seconds');

subplot(2,2,2);
plot(t, v_slow, 'k', t, v_slow, 'ok');
grid;
title('velocity, slow');
xlabel('seconds');

subplot(2,2,4);
plot(t, v_fast, 'k', t, v_fast, 'ok');
grid;
title('velocity, fast');
xlabel('seconds');

gzweigle, 2024-10-20:
With respect to my observation (B) and this comment in op - "...something in the code is too slow to keep pace and measure them fast enough..."
After thinking about it.
At both hammer and flange, the motion start time and end time are the same.  All that differs is a numerical value.  Therefore, the 300us sample rate is ok for both.  In other words, the "code speed" is ok for measuring at hammer.  The problem is somewhere else.

gzweigle, 2024-10-20:
OK, I was able to get the piano to work, using the test setup (picture in previous comment) with sensor over hammer.

The hammer travels approximately 40mm. The CNY70 and QRE1113 cover a 10X collector current range starting at approximately 5 - 7 mm. This is from my understanding of the datasheets.

Here are the new settings values (hammer_settings.cpp file):

I changed the hammer algorithm to threshold. Maybe not required. But simplified getting it to work.
hammer_strike_algorithm = 1;

Then, I moved the threshold down significantly. Because of the 40 mm vs "5 mm" ranges.
strike_threshold = 0.7;

Also, changed the velocity scaling to a smaller value. This is because of the large nonlinearity when the hammer "comes into view" of the sensor:
velocity_scale = 0.10;

To get the note to sustain, I had to set the threshold quite small, because the catch position is outside the sensor normal range.
damper_threshold = 0.06;

I used the Ethernet streamed data to help me set the above values.

Here is the results for playing A0 soft and loud:

MIDI note (21) index (0) velocity (90) is now ON.
MIDI note (21) index (0) velocity (0) is now OFF.
MIDI note (21) index (0) velocity (66) is now ON.
MIDI note (21) index (0) velocity (0) is now OFF.
MIDI note (21) index (0) velocity (78) is now ON.
MIDI note (21) index (0) velocity (0) is now OFF.
MIDI note (21) index (0) velocity (50) is now ON.
MIDI note (21) index (0) velocity (0) is now OFF.
MIDI note (21) index (0) velocity (97) is now ON.
MIDI note (21) index (0) velocity (0) is now OFF.
MIDI note (21) index (0) velocity (107) is now ON.
MIDI note (21) index (0) velocity (0) is now OFF.
MIDI note (21) index (0) velocity (23) is now ON.
MIDI note (21) index (0) velocity (0) is now OFF.

The white sticker does not want to stay on the felt hammer! That was the biggest problem.

gzweigle, 2024-10-20:
For tests above, I turned calibration off by setting switch sca_sw1_position1 to the ON position.
Because of 40 mm vs "5 mm" the calibration code may need changes. So I didn't want it confusing matters.
The piano will play without calibration. Calibration makes the piano much more accurate but is not required for basic playing.

davidedelvento, 2024-10-20:
Thanks Greg for this wealth of information. I am starting this test right now!

FWIW, I was doing almost the same things you are, my major difference was

```
strike_threshold = 0.7;
velocity_scale = 0.10;
```

which instead I had to values closer to default. I'll let you know shortly where I land!

davidedelvento, 2024-10-20:
Velocity scale was the main culprit, looks like now I am in business, and the piano is somewhat working. I will play with the various settings and in auto-calibration soon and see how things go.

I guess part of my confusion when exploring this alone, was that I was thinking of the `velocity_scale` as something relevant to MIDI and not to the ADC data which I expected to see similar to the following regardless of the `velocity_scale` value. I need to fully understand what that does exactly and maybe we need to document it for others

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

There are two possible problems that I still see from this picture:

1) the ripples (not very visible with this scale but always there) which are especially clear if there is no hammerstrike. This is not trivial 60Hz light noise because I've tested it in the dark, however it can be one of the plenty LEDs on the IPS board, e.g. the Ethernet ones which are actually pointing toward the direction of the note I'm testing. I will try some screening but to help debugging I need confirmation of the duration of each line in the captured `hammer_position.txt` file: is that 300us?

2) I may be clipping at the closest hammer-sensor distances which (if true) means I should change the resistor on the ACE board :disappointed:

gzweigle, 2024-10-20:
(1) "to help debugging I need confirmation of the duration of each line"

Yes, each row in the file is one set of samples and the sample period is 300 microseconds.

The sample period is set by the adc_sample_period_microseconds value in hammer_settings.cpp.

The sample period value must be larger than the time it takes for all processing in the Teensy.  Oscilloscope testing (using a test point on the board) I've measured the Teensy processing to take approximately 250 microseconds.  So, I used a 300 microsecond sample interval to give a little margin.

If the codebase ever needs large changes, that could necessitate changing the sample rate.

There are no restrictions on making the sample period longer (sample rate slower), other than it makes the velocity estimates less accurate.  I have occasionally used longer sample periods when I had to add a large amount of test code for debugging things.  This is something to be aware of.  If you ever add a lot of test code and suddenly see really strange behavior, try increasing the sample period temporarily to something like 400 microseconds.

I've also tested with shorter sample periods (much faster sample rates) by removing some of the "unnecessary" Teensy code.

davidedelvento, 2024-10-20:
Thanks again!

That noise is indeed at 60Hz, so it must be coming somewhere from the AC distribution frequency. I tried a few other things, including routing the AC power supply elsewhere (as I wrote, this is already with lights off and inside an enclosure, so the only possible luminal noise would be the LEDs on the IPS). I also wired one octave using the Ethernet cables for most of the distance (of course there were still short jumpers, but I twisted them), and the noise remained the same. Here is a close-up

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

The waveform of this noise is peculiar and I think that is telling me something, so I did the FFT and it's telling me (as obvious from the time domain plot too) that there are many other frequencies, but most importantly (which was not obvious from the time domain plot) that the vast majority of the noise is coming from the harmonics of the 60Hz

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

Cleaning up the FFT spectrum removing everything under `2e-5` and performing the inverse creates almost exactly the noise from the time domain, so there is nothing else. I guess the next thing I will try is to battery power the LEDs so I can distinguish LED noise vs sensor/ADC noise (I could do that with an oscilloscope, but I don't have a portable one and the instrument is in a cabinet in a bedroom, so batteries are more practical)

gzweigle, 2025-05-04:
Did this get resolved?
If so, we can close the issue.

davidedelvento, 2025-05-04:
Did it get resolved? Yes, maybe and no.

Yes: if I power everything from batteries, this problem is gone.
Maybe: if I power everything from an excellent power source (e.g. a linear power supply), I can probably still see this issue, but I need to look pretty hard to find it.
No: if I power the LEDs from an excellent linear power supply and the rest of the board from the USB, the problem is still there. Among the ones I have tried, some computers have really bad spectrum (e.g. cheap, old, laptop), and some others are decent (but I would not call them acceptable, e.g. old iMac).

So in conclusion, I think you should do either (or both) of the following:

* mention this problem somewhere in the documentation, warning people to use the best power supply they can afford (and avoid USB-powering at all costs, which I know at least two other people on pianoclack are instead interested in exploring)
* see if you can change anything in the power circuit (of the digital) to make this problem moot. The easy/obvious way would be to add some large capacitor to make a low pass filter. Depending on the power draw that might or might not be practical, I'll leave it to you to check what is the case -- taking also in mind that large electrolytic capacitors have a finite lifespan which may cause problems down the road...

Feel free to close it if you plan to do no action, or to keep it open as a reminder

gzweigle, 2025-05-04:
Interesting...

During earlier development I would often run the piano with USB power. Although never with all 88 keys (only with a subset of sensors, that USB could handle without exceeding its limit).

For example, note here the power input isn't soldered, only USB.
https://youtu.be/DxdRO3M7cgg?t=227

For reference, here is the existing power supply documentation:
https://github.com/stem-piano/stem-piano-g-main/blob/main/documentation/component_manual.md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
I could put the warning in this section.

gzweigle, 2025-05-04:
Added documentation at link above on power supply noise.
Also noted what power supply conditioning is presently on the PCBs, for example the LDOs.

Closed 2025-05-04.

Thread 111 (2025-01-27):

Main board fails to initialize if pedals are in some circumstances

davidedelvento, 2025-01-27:
I finally managed to wire the pedals (which given the geometry of my setup was very challenging). For all three pedals, I am using https://www.sparkfun.com/sparkfun-line-sensor-breakout-qre1113-analog.html as pedal sensor.

I have all three pedals connected to the main board, the board does not initialize, does not present itself over USB-MIDI and does not even connect to Ethernet. If I disconnect two pedals and leave just one, it still behaves in this anomalous way.

However, in the single pedal case ONLY, the main board behaves correctly if before starting the boot, I keep the pedal down (which mean keeping the distance from the sensor high). I cannot reproduce this correct behavior with two or three pedals connected, regardless of how I keep the pedals during the boot.

I am sure there must be something wrong with either my wiring or my sensors, but I think that this can still be considered a firmware bug since even with incorrect data coming from the sensors the board should boot correctly (and help me debug what is wrong, ideally, e.g. by dumping over ethernet the wrong values of the pedals), hence I'm reporting this here.

As a side note, from this behavior, do you have any clue about what might be wrong?

gzweigle, 2025-01-27:
You may want to try putting a

Serial.println("got here");

after each function call in setup()

(and loop() if the code completes setup() ok).

To find where the code hangs.

gzweigle, 2025-01-27:
Also, here is what I put in the help file for similar symptoms.  May give ideas for places to look:

https://github.com/stem-piano/stem-piano-top/blob/main/HELP.md#the-piano-does-not-work-at-all

gzweigle, 2025-04-26:
Close based on adding further help as described above.
Can reopen if issue persists.

Closed 2025-04-26.

Thread 116 (2025-04-26):

FW: very long delay for a debug message

gzweigle, 2025-04-26:
The debug message printing key min/max in hammer_status.cpp can take longer than a processing interval.
Could be causing intermittent note issues.
Should rewrite to print in subsections.

gzweigle, 2025-05-05:
Fixed by printing stats for only one note per sampling interval (when debug messages is enabled).
It takes 96 sampling intervals to print stats for all notes, which is on the order of tens of milliseconds and not visible to the user.

Closed 2025-05-05.

Thread 118 (2025-04-26):

FW: debug for processor burden

gzweigle, 2025-04-26:
I chased a processor burden issue and decided to add code that continuously checks this.

gzweigle, 2025-04-26:
Check added in timing.cpp.
Regular status (if debug messages enabled) added to hammer_status.cpp.

New features are useful both to:
Get a warning if the processing time exceeds the ADC conversion time.
Also useful for determining the fastest possible ADC sample rate based on processor burden.

Closed 2025-04-26.

Thread 120 (2025-05-05):

FW: sample rate to 4K

gzweigle, 2025-05-05:
Sample period has been 300 microseconds (3,333 samples per second).

Based on results of new statistics added to code, 250 microseconds (4,000 samples per second) is possible.

Signal analysis shows both are well within the Nyquist rate.  But, if can run faster, why not!

gzweigle, 2025-05-05:
Done.
Running long-term statistics show the max processing interval is 217 microseconds.  So, 4.5Ksps is possible.  And, with some code optimization perhaps as fast as 5Ksps in the future.

gzweigle, 2025-05-10:
Using hammer board for both hammer and damper measurements = 217 microseconds.

When add a damper board and use dampers for damper measurements, this adds the board-to-board communication delays. The total with damper board is 235 microseconds.
The damper board (which has less processing) is at 193 microseconds.

The idea in this issue would even-out the hammer and damper board processing burden, resulting in a faster top sample rate: https://github.com/gzweigle/open-hybrid-piano/issues/9

Closed 2025-05-05.

Thread 121 (2025-05-12):

FW: damper board mysteriously can cause notes to not play

gzweigle, 2025-05-12:
This was a fun bug to track down.
When the damper board is connected sometimes notes do not play.

The problem is with the optional auto-mute function.
The auto-mute will mute all notes if it detects too many notes at max velocity.
Just in case of a firmware bug it prevents a loud sound.

The bug is caused by checking for max velocity also on the damper release velocity.
This could happen under normal conditions depending on how damper velocity is computed.
But it will never cause too loud of a sound (unlike forte fortissimo of hammer).

Fix by running auto-mute only for hammer velocity.

gzweigle, 2025-05-12:
pushed fix

Closed 2025-05-12.

Thread 122 (2025-05-16):

FW: incorrect short sustain

gzweigle, 2025-05-16:
Very infrequently sometimes a note does not sustain while the key is pressed.

gzweigle, 2025-05-16:
When quantizing damper positions for sending over CAN bus to hammer PCB, if the damper position is exactly 1.0 then it got truncated to a value of 0x00.  Hammer position after normalization should be [-1.0, ..., 1.0].  I didn't notice the corner case for value of 1.0.

The rarely happened because a value of 1.0 is uncommon.  For example 0.99 works fine!

The hammer and damper processing code interpreted a value of 0x00 as damper at virtual strings when actually it was damper maximally far from a virtual piano string.

Fix with a logic test for large and small values instead of a logical AND of bits.

Closed 2025-05-16.

Thread 123 (2025-05-16):

FW: incorrect long sustain

gzweigle, 2025-05-16:
Very infrequently, sometimes a note continues to sustain after it is released.
This is with the damper board.

gzweigle, 2025-05-18:
From the code comments:
// It is possible to slightly impulse a key, give the hammer enough
// momentum to cross the strike threshold, but the key not pressed
// deep enough to cross the damper threshold. This causes a MIDI ON
// event but not a MIDI OFF event and so the note sustains incorrectly.

The root cause of the issue is that for MIDI the software must send damper events and a velocity of the event.  But a damper operates based on position. Therefore I wrote a function that checks for hammer and damper synchronization inconsistency and corrects.

Closed 2025-05-18.

Thread 124 (2025-05-16):

FW: sample rate with damper board

gzweigle, 2025-05-16:
With the damper board, the board-to-board communication processing time puts the total processing time as high as 302 microseconds.
Could this be optimized?
Doesn't seem like it should take so long.

gzweigle, 2025-05-17:
This problem appears to be from debug code.
Back to 236us max with board-to-board comm processing but without the debug code.

gzweigle, 2025-05-18:
Let piano run for days at 4000 samples per second ADC rate.
Processor burden never exceeded 250 microseconds.

Closed 2025-05-18.

Thread 128 (2025-05-18):

FW: improve piano precision

gzweigle, 2025-05-18:
Increase the hammer strike threshold setting.
Calibration is proving to be very robust.
Therefore, I can decrease a setting-controlled tolerance and this makes the instrument more precise.
Tested to prove it works reliably.

gzweigle, 2025-05-18:
Done

Closed 2025-05-18.

Thread 130 (2025-05-31):

FW: improve debug messages for damper

gzweigle, 2025-05-31:
I fixed hammer debug messages causing code execution to exceed ADC sample period [1].  Need to do the same for dampers.

[1] reference issue: (https://github.com/gzweigle/open-hybrid-piano/issues/126)

Thread 131 (2025-05-31):

FW: occasional broken note

gzweigle, 2025-05-31:
Sometimes a piano key stops working. Usually immediately after powerup. Must rerun the autocalibration algorithm. Then it works.

To debug I am recording the voltage when hammer (or damper) is closest to the sensor. This is for a key press and hammer strike. Record these voltage values for all 88 keys once per day.

The plot below shows preliminary statistics of voltage variation when the hammer (or damper) is closest to the sensor.  Plot is the maximum voltage recorded over multiple days, minus the minimum voltage recorded over multiple days, for each key.

The sensors output voltage is from 0 volts (when key is at rest) to a potential max of 2.5 volts (when key is fully depressed and hammer is hitting a virtual string). So, the voltage range in plot for each key is quite high compared to 2.5V.

Also the variation is much higher for dampers compared to hammers, I don't know why.

I don't know if the variation is due to:
- mechanical variation in action
- slight perturbations in the sensor location as a result of forces when playing the piano
- CNY70 tolerances
- subtle lighting changes (although, the sensors are covered)
- ???

In any case, the piano algorithm needs to account for this variation. It is not acceptable that keys can randomly stop working and then the user has to manually restart a calibration sequence.

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

Thread 132 (2025-06-06):

FW: yet another accuracy research

gzweigle, 2025-06-06:
When playing piano, still not 100% happy with the accuracy.

Also discussed here:
https://github.com/gzweigle/open-hybrid-piano/issues/14
https://github.com/gzweigle/open-hybrid-piano/issues/55
https://github.com/gzweigle/open-hybrid-piano/issues/63

And here:
https://www.youtube.com/watch?v=TemXGmkoc-g
https://www.youtube.com/watch?v=yqkRKSGX6kw

davidedelvento, 2025-06-22:
Thanks for sharing. Have you redone the mechanical structure of the sensors as you suggested you were doing in one of your updates?

I think using the cheap L extrusions from hardware store is one (major?) source of your problems since they are not rigid enough and prone to bending and vibrating, let alone being accurate in the initial position. I think 4040 extrusions (like the ones I am using) are a solution to this part of the problem.

Also, having your sensors on the shank, IMHO complicates the matters since there is possibly a note-to-note variation and calibration needed. I think my design of having the sensors on the hammers, with a set spacer with a small hole dramatically improves this problem too, since now each note is exactly sensed then the hammer hits the spacer and the sensor notice it from the small hole (remember, I use small sensors, not the huge CNY70).

I will still have a problem with possibly different reflectivity from note to note, due to difference in hammer felt, but I think I can solve that by filing, which is pretty easy to do (even if a bit messy, but my design allows removal of the action from the cabinet, so the electronics is not affect by that).

To be completely open, none of these are my inventions, I've just taken them from Jay, like I took the electronics and firmware from you. Since you're going faster than I (I'm still stuck at cabling) I wonder if you tested these other options and reached any conclusions.

gzweigle, 2025-06-22:
Thanks. Cool to see a different approaches in the works.

One of my design requirements is sampled position measurements, hammer and damper. So I need the sensed surface to stay less than 8 - 10 millimeters from the sensor. And closer than that is better. Hence shank.

For accuracy, I am working on an optional plug-in addition (to existing hardware system) reference the digital calibration algorithms.

My goal went from "make an open source hybrid piano that works", to "make an open source hybrid piano with high precision and accuracy".

gzweigle, 2025-06-28:
Here is a writeup.

It seems to work. Will make a video when get time someday.

https://github.com/gzweigle/hybrid-piano-calibration/tree/main/pdps

gzweigle, 2025-06-28:
Some browsers are better than others at displaying the equations and equation numbers in document linked above.
