gzweigle/DIY-Grand-Digital-Piano/firmware/releases/ips2_damper/ips2_damper.ino

// Copyright (C) 2025 Greg C. Zweigle
//
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
// Location of documentation, code, and design:
// https://github.com/gzweigle/open-hybrid-piano
// https://github.com/stem-piano
//
// src_damper.cpp
//
// For ips pcb version 2.X
// For sca pcb version 0.0
//
// Main code for damper board of stem piano.
//
// stem piano is an open source hybrid digital piano.
//

#include "stem_piano_ips2.h"

#include "damper_settings.h"
#include "six_channel_analog_00.h"
#include "board2board.h"
#include "calibration_position.h"
#include "damper_status.h"
#include "network.h"
#include "nonvolatile.h"
#include "switches.h"
#include "testpoint_led.h"
#include "timing.h"
#include "tft_display.h"

DamperSettings Set;
SixChannelAnalog00 Adc;
Board2Board B2B;
CalibrationPosition CalP;
DamperStatus DStat;
Network Eth;
Nonvolatile Nonv;
Switches SwIPS1;
Switches SwIPS2;
Switches SwSCA1;
Switches SwSCA2;
TestpointLed Tpl;
Timing Tmg;
TftDisplay Tft;

void setup(void) {
  // Load the settings. Must be first in the setup() function.
  Set.SetAllSettingValues();

  partial_setup();
}

void partial_setup(void) {
  // Serial port setup.
  Serial.begin(9600);
  Serial.println(".");
  Serial.println(".");
  Serial.println("welcome to stem piano by gcz");
  Serial.println("an open source, hybrid piano");
  Serial.println(".");
  Serial.println(".");

  // Important information.
  Serial.println("Hardware required:");
  Serial.println("  IPS2.X hammer board.");
  Serial.println("  SCA0.0 analog board.");
  Serial.println("  HPS 0.8, 0.7, or 0.4 sensor board (any board meeting spec is also ok).");
  Serial.println("License: GNU GPLv3 - for documentation, code, and design see:");
  Serial.println("https://github.com/gzweigle/open-hybrid-piano");
  Serial.println("https://github.com/stem-piano");
  Serial.println(".");
  Serial.println(".");

  // Notification messages.
  if (Set.debug_level >= DEBUG_INFO) {
    Serial.println("Beginning damper board initialization.");
  }
  Tft.Setup(Set.using_display, Set.debug_level);
  Tft.HelloWorld();

  // Initialize the nonvolatile memory.
  // Initialize early in case any setup() uses storage.
  Nonv.Setup(Set.debug_level);

  // Setup reading the switches.
  SwIPS1.Setup(Set.switch_debounce_micro,
  Set.switch11_ips_pin, Set.switch12_ips_pin, Set.debug_level);
  SwIPS2.Setup(Set.switch_debounce_micro,
  Set.switch21_ips_pin, Set.switch22_ips_pin, Set.debug_level);
  SwSCA1.Setup(Set.switch_debounce_micro,
  Set.switch11_sca_pin, Set.switch12_sca_pin, Set.debug_level);
  SwSCA2.Setup(Set.switch_debounce_micro,
  Set.switch21_sca_pin, Set.switch22_sca_pin, Set.debug_level);

  // Setup the analog front-end and the board-to-board communication.
  // Physically connecting the board-to-board link is optional and
  // only required if using a separate set of sensors for the dampers.
  // These two classes are common to hammer and pedal boards.
  Adc.Setup(Set.adc_spi_clock_frequency, Set.adc_is_differential,
  Set.using18bitadc, Set.sensor_v_max, Set.adc_reference,
  Set.adc_global_scale, Set.reorder_list, &Tpl);
  B2B.Setup(Set.canbus_enable);

  // Diagnostics and status
  DStat.Setup(&Tpl, Set.debug_level);

  // Common on hammer and pedal board: Ethernet, test points, TFT display, etc.
  CalP.Setup(Set.calibration_threshold, Set.debug_level, &Nonv);
  Eth.Setup(Set.true_for_tcp_else_udp, Set.computer_ip, Set.teensy_ip,
    Set.network_port, SwIPS2.direct_read_switch_2(), Set.debug_level);
  Tpl.Setup();
  Tmg.Setup(Set.adc_sample_period_microseconds, Set.debug_level);

  if (Set.test_index >= 0) {
    Serial.println("WARNING - In high-speed test mode.");
    Serial.println("MIDI is disabled.");
  }

  // Ready to be a piano (damper).
  if (Set.debug_level >= DEBUG_INFO) {
    Serial.println("Finished damper board initialization.");
  }
  delay(1000);
  Tft.Clear();

  Serial.println("Press 1 to enter parameter edit mode.");
}

// After startup, wait before sending anything to MIDI
// in order to avoid any potential startup transients.
int startup_counter = 0;

// Switches.
bool switch_enable_ethernet;
bool switch_require_tcp_connection;
bool switch_tft_display;
bool switch_freeze_cal_values;
bool switch_disable_and_reset_calibration;

// Data from ADC.
unsigned int raw_samples[NUM_CHANNELS];
unsigned int raw_samples_reversed[NUM_CHANNELS];
unsigned int raw_samples_reordered[NUM_CHANNELS];
int position_adc_counts[NUM_CHANNELS];

// Damper, hammer, and pedal data.
float damper_position[NUM_CHANNELS], calibrated_floats[NUM_CHANNELS],
position_floats[NUM_CHANNELS];

// Damper threshold for display
float damper_threshold_low = 0.33;
float damper_threshold_med = 0.50;
float damper_threshold_high = 0.75;

int input_field = -1;
bool keep_editing = false;

void edit_parameters() {
  // effectively "infinite" timeout (~ 1 month) when waiting for input
  // in this function (parameter editing mode)
  Serial.setTimeout(2073600000L);

  Serial.println("Entered parameter editing mode.");
  keep_editing = true;
  while (keep_editing) {
    Serial.println("Which parameter would you like to edit?");
    Serial.println("0. NONE, done editing, resume normal operations");
    Serial.println("1. debug_level");
    Serial.println("2. sensor_v_max");
    Serial.println("3. adc_reference");
    Serial.println("4. adc_global_scale");
    Serial.println("5. N/A");
    Serial.println("6. calibration_threshold");

    if (Serial.available() > 0) {
      input_field = Serial.parseInt();
      switch (input_field) {
        case 0:
           // taken care of later
          break;
        case 1:
          // debug_level is INTEGER!
          Serial.print("Enter debug_level, currently ");
          Serial.println(Set.debug_level);
          Set.debug_level = Serial.parseInt();
          Serial.print("Set debug_level = ");
          Serial.println(Set.debug_level);
          break;
        case 2:
          Serial.print("Enter sensor_v_max, currently ");
          Serial.println(Set.sensor_v_max);
          Set.sensor_v_max = Serial.parseFloat();
          Serial.print("Set sensor_v_max = ");
          Serial.println(Set.sensor_v_max);
          break;
        case 3:
          Serial.print("Enter adc_reference, currently ");
          Serial.println(Set.adc_reference);
          Set.adc_reference = Serial.parseFloat();
          Serial.print("Set adc_reference = ");
          Serial.println(Set.adc_reference);
          break;
        case 4:
          Serial.print("Enter adc_global_scale, currently ");
          Serial.println(Set.adc_global_scale);
          Set.adc_global_scale = Serial.parseFloat();
          Serial.print("Set adc_global_scale = ");
          Serial.println(Set.adc_global_scale);
          break;
        case 6:
          Serial.print("Enter calibration_threshold, currently ");
          Serial.println(Set.calibration_threshold);
          Set.calibration_threshold = Serial.parseFloat();
          Serial.print("Set calibration_threshold = ");
          Serial.println(Set.calibration_threshold);
          break;

        default:
          Serial.print("Case ");
          Serial.print(input_field);
          Serial.println(" not supported");
          break;
      }
      if (input_field == 0) {
        keep_editing = false;
      }
    }
    delay(100);
  }

  // restore default timeout outside of parameter editing mode
  Serial.setTimeout(1000L);

  // re-run the set up with the changed values (may be unnecessary)
  Serial.println("Setting up the board with your changes");
  partial_setup();
}

void loop() {

  if (Serial.available() > 0) {
    input_field = Serial.parseInt(); // defaults to zero if times out
    if (input_field == 1) {
      edit_parameters();
    }
  }

  Tmg.WarnOnProcessingInterval();
  DStat.DisplayProcessingIntervalStart();

  // Measure every processing interval so the pickup and
  // dropout timers update. Later, when a switch is read,
  // what is actually read is the internal state of timers.
  SwIPS1.updatePuDoState("IPS11", "IPS12");
  SwIPS2.updatePuDoState("IPS21", "IPS22");
  SwSCA2.updatePuDoState("SCA21", "SCA22");
  SwSCA1.updatePuDoState("SCA11", "SCA12");

  // Read all switch inputs.

  // ips_sw1_position2 (ENABLE_TFT).
  switch_tft_display = SwIPS1.read_switch_2();

  // ips_sw2_position2 (ENABLE_ETHERNET).
  switch_enable_ethernet = SwIPS2.read_switch_2();

  // ips_sw2_position1 (REQUIRE_TCP).
  switch_require_tcp_connection = SwIPS2.read_switch_1();

  // sca_sw1_position2 (FREEZE_CAL_VALUES).
  switch_freeze_cal_values = SwSCA1.read_switch_2();

  // sca_sw1_positon1 (DELETE_CAL_VALUES).
  switch_disable_and_reset_calibration = SwSCA1.read_switch_1();

  // When the TFT is operational.
  // Slow down sampling because the TFT takes a long time for
  // processing. But, do keep the sampling going so that the TFT
  // can display things like maximum and minimum hammer positions.
  if (switch_tft_display == true) {
    switch_freeze_cal_values = true; // Ignore switch value.
    Tmg.ResetInterval(Set.adc_sample_period_microseconds_during_tft);
  }
  else {
    Tmg.ResetInterval(Set.adc_sample_period_microseconds);
  }

  // This if statement determines the sample rate.
  // Everything below in this file runs at the sample rate.
  if (Tmg.AllowProcessing() == true) {

    Tpl.SetTp8(true); // Front left test point asserts during processing.

    // Get damper data from ADC.
    Adc.GetNewAdcValues(raw_samples, Set.test_index);

    // Reverse the back row since a damper board is
    // rotated 180 degrees compared to a hammer board.
    // Use NUM_CHANNELS - 8 because not reversing the
    // eight inputs typically used for pedals.
    for (int ind = 0; ind < NUM_CHANNELS - 8; ind++) {
      raw_samples_reversed[ind] = raw_samples[NUM_CHANNELS - ind - 1 - 8];
    }

    // Reorder the back row.
    Adc.ReorderAdcValues(raw_samples_reordered, raw_samples_reversed);

    // Normalize the ADC values.
    Adc.NormalizeAdcValues(position_adc_counts, position_floats, raw_samples_reordered);

    // Undo the position errors due to physical tolerances.
    bool all_notes_using_cal = CalP.Calibration(switch_freeze_cal_values,
    switch_disable_and_reset_calibration, calibrated_floats, position_floats);

    // Zero out the signal from any unconnected pins to avoid noise
    // or anything else causing an unwanted piano note to play.
    for (int k = 0; k < NUM_CHANNELS; k++) {
      if (Set.connected_channel[k] == false) {
        position_adc_counts[k] = 0;
        calibrated_floats[k] = 0.0;
      }
#ifdef REVERSE_DAMPERS
      else {
        calibrated_floats[k] = 1 - calibrated_floats[k];
      }
#endif
    }

    B2B.SendDamperData(calibrated_floats);
    Eth.SendPianoPacket(calibrated_floats, calibrated_floats,
      switch_enable_ethernet, switch_require_tcp_connection, Set.test_index);

    if (Set.test_index < 0) {
      // Run the TFT display.
      Tft.Display(switch_tft_display, calibrated_floats, damper_position);
    }

    // Debug and display information.
    DStat.FrontLed(calibrated_floats, damper_threshold_low, damper_threshold_med,
    damper_threshold_high, Set.test_index);

    if (Set.test_index < 0) {
      DStat.LowerRightLed(all_notes_using_cal, Nonv.NonvolatileWasWritten());
      DStat.SCALed();
      DStat.EthernetLed();
      DStat.SerialMonitor(position_adc_counts, calibrated_floats,
      calibrated_floats[0], position_floats[0],
      calibrated_floats[1], position_floats[1],
      calibrated_floats[2], position_floats[2],
      calibrated_floats[3], position_floats[3],
      calibrated_floats[4], position_floats[4],
      calibrated_floats[5], position_floats[5],
      calibrated_floats[6], position_floats[6],
      calibrated_floats[7], position_floats[7]);
    }

    Tpl.SetTp8(false);

  }

  DStat.DisplayProcessingIntervalEnd();
}
